munchsubal/5-bit-cla/report.pdf

# VLSI Project

Subal Manchanda : 2024102033

December 2025

## 1 Proposed Structure

I have implemented a 5-bit CLA adder implementation in which we have a Carry-Lookahead Logic broken into 3 parts (2-2-1). I have used AO21 gates for optimising delay along the critical path and also used traditional CMOS gates like AND, NOT. Also, I have used D-Flip Flops for gatekeeping inputs and outputs to ensure proper timing in a real life application. This adder implementation does not use more than 2-input AND Gates which leads to a less fan-in. The block diagram of the circuit is given below:

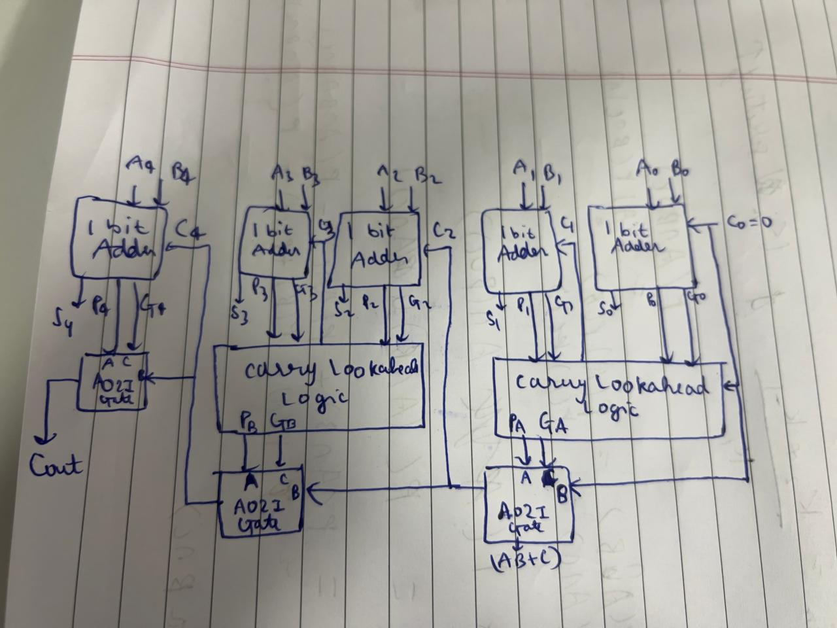
[picture p1: figure]

## 2 Design details of each block

Taking W = 10 * LAMBDA

Gates:

### 2.1 AND GATE

This has been implemented using static CMOS logic with sizing as shown in the figure.

1

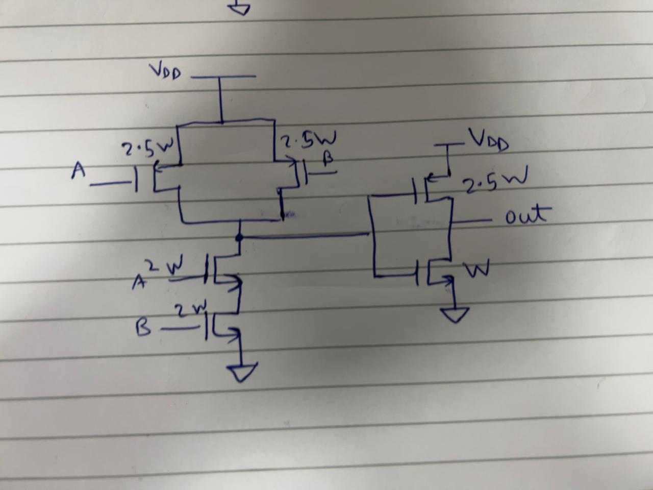
[picture p2: figure]

### 2.2 NOT GATE

This has been implemented using static CMOS logic with sizing as shown in the figure.

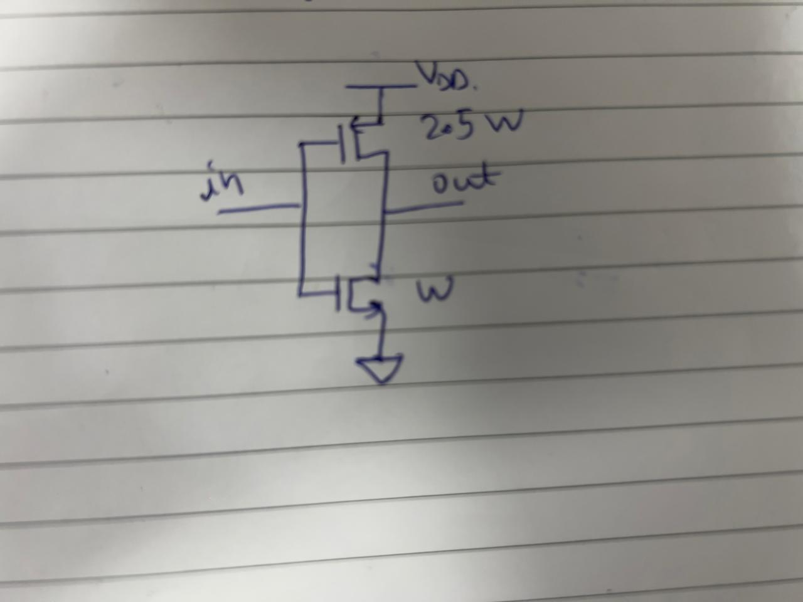
[picture p3: figure]

### 2.3 AO21 Gate

This has been implemented using static CMOS logic with sizing as shown in the figure.

2

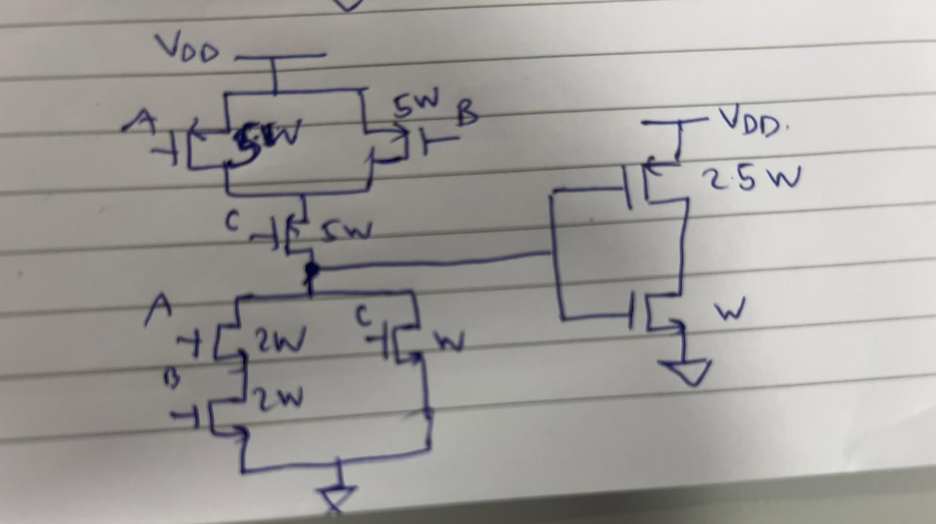
[picture p4: figure]

### 2.4 XOR Gate

This has been implemented using Transmission gate logic with sizing as shown in the figure.

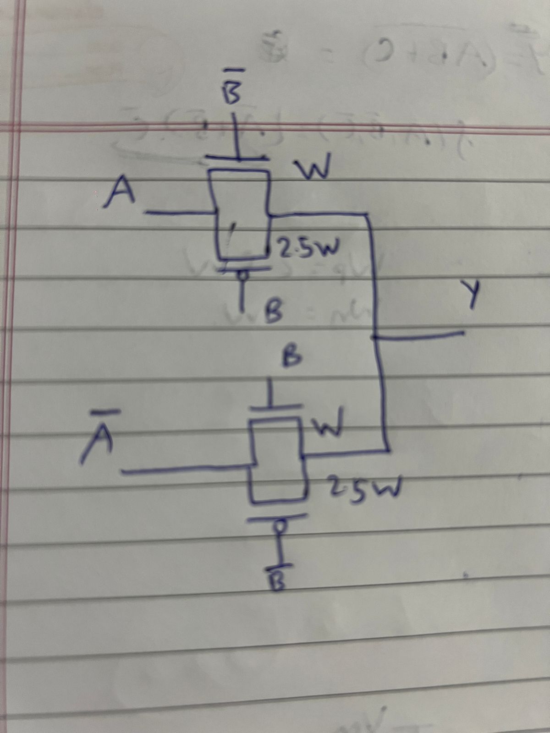
[picture p5: figure]

Different blocks in the circuit:

2.5 1-bit Adder

The adder block has been implemented as follows using the gates we described above:

3

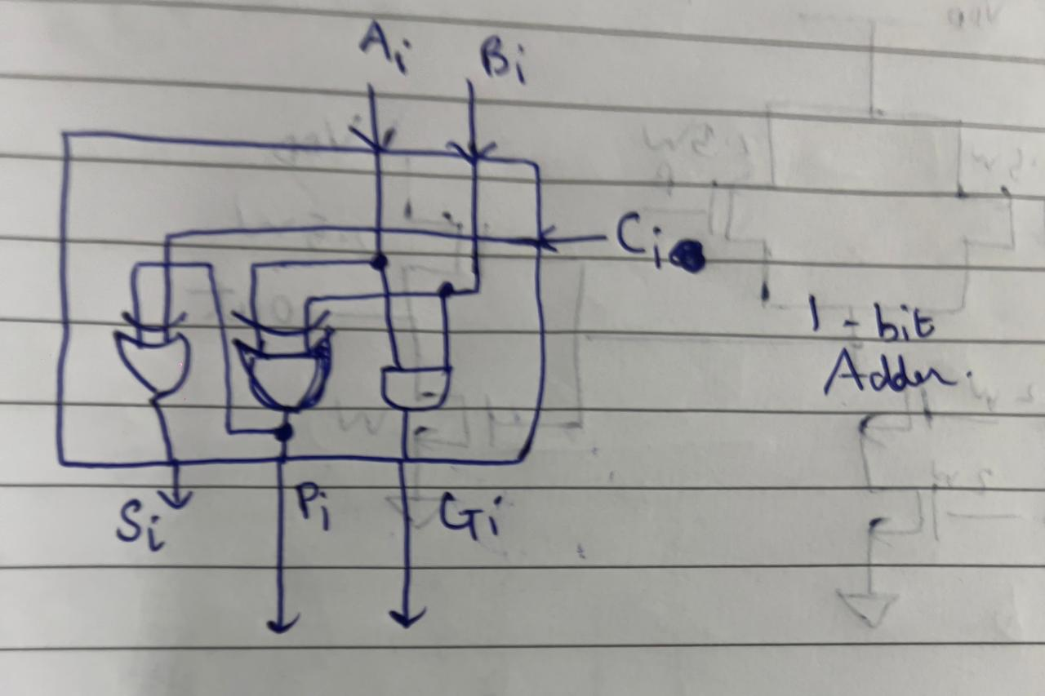
[picture p6: figure]

The adder block provides the propogate and generate bit, along with computing the sum bit as follows:

P = A ⊕ B

G = A · B

S = P ⊕ Cin

### 2.6 Carry Lookahead Logic (CLL) Block

The CLL block has been implemented as follows using the gates we described above:

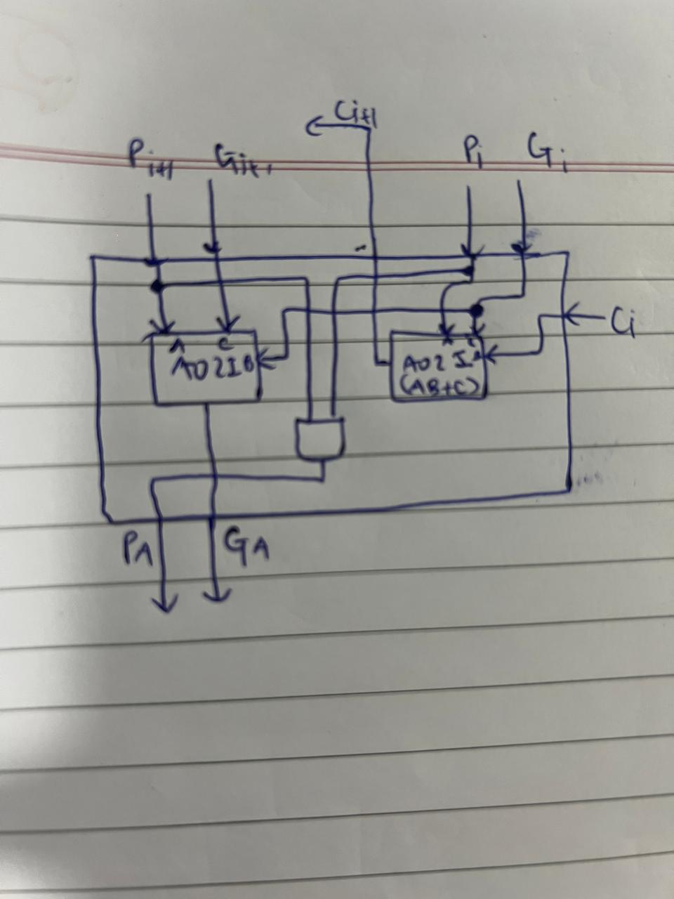
[picture p7: figure]

4

The CLL block implements the following logics:

Ci+1 = Gi + PiCi

PA = Pi+1Pi

GA = Gi+1 + Pi+1Gi

### 2.7 D Flip-Flop

This has been implemented using TSPC logic style as shown in the figure with sizing shown:

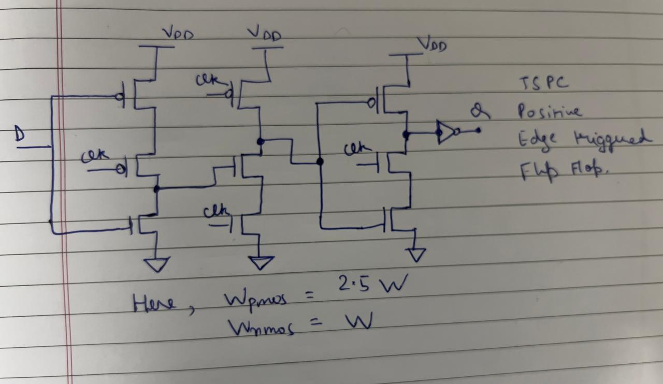
[picture p8: figure]

## 3 Simulating Each Gate seperately:

### 3.1 AND GATE

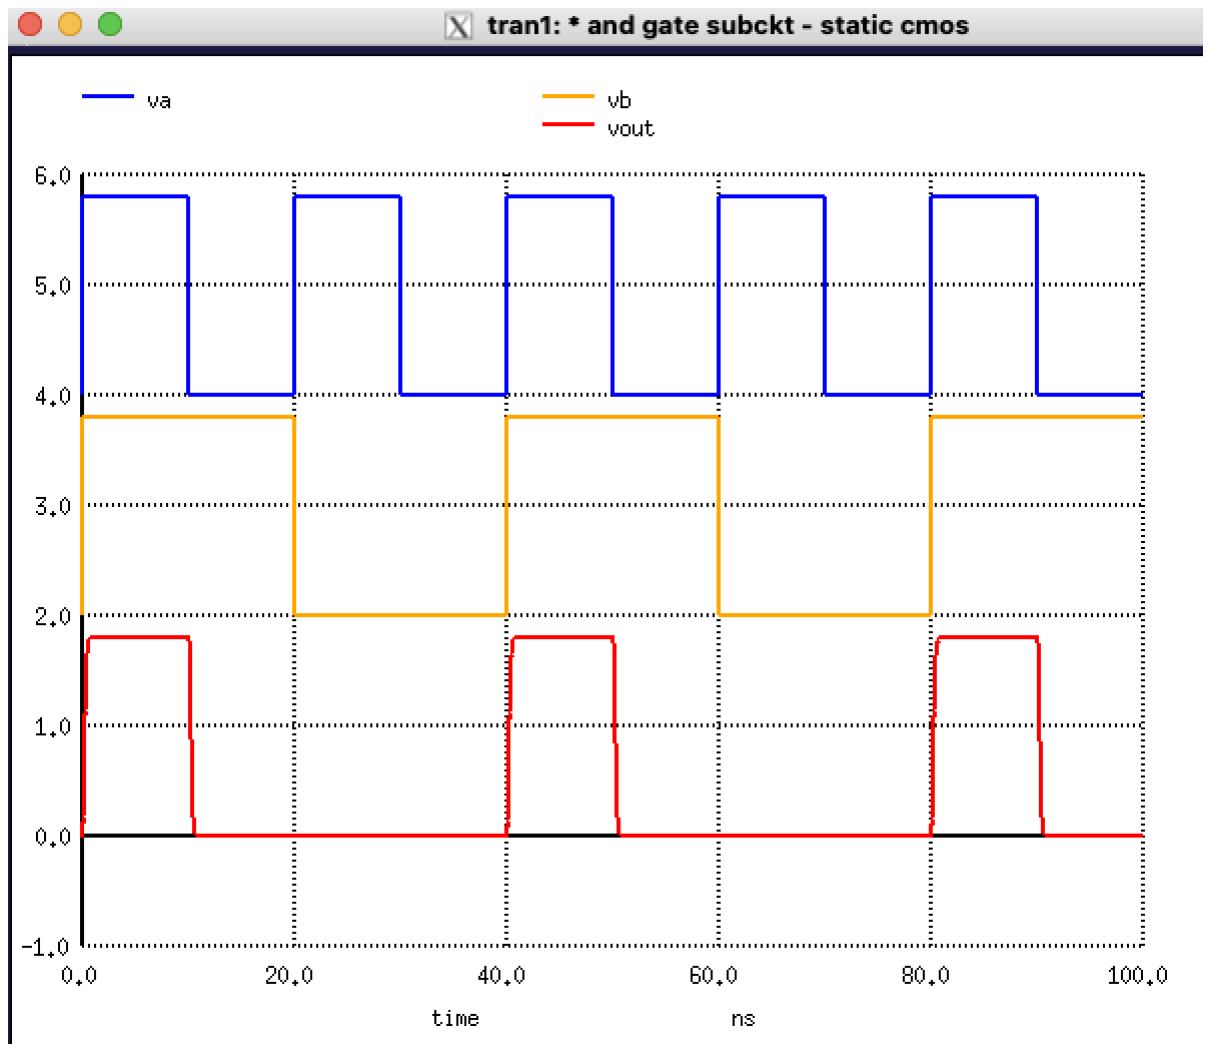
[picture p9: figure]

5

### 3.2 AO21 GATE

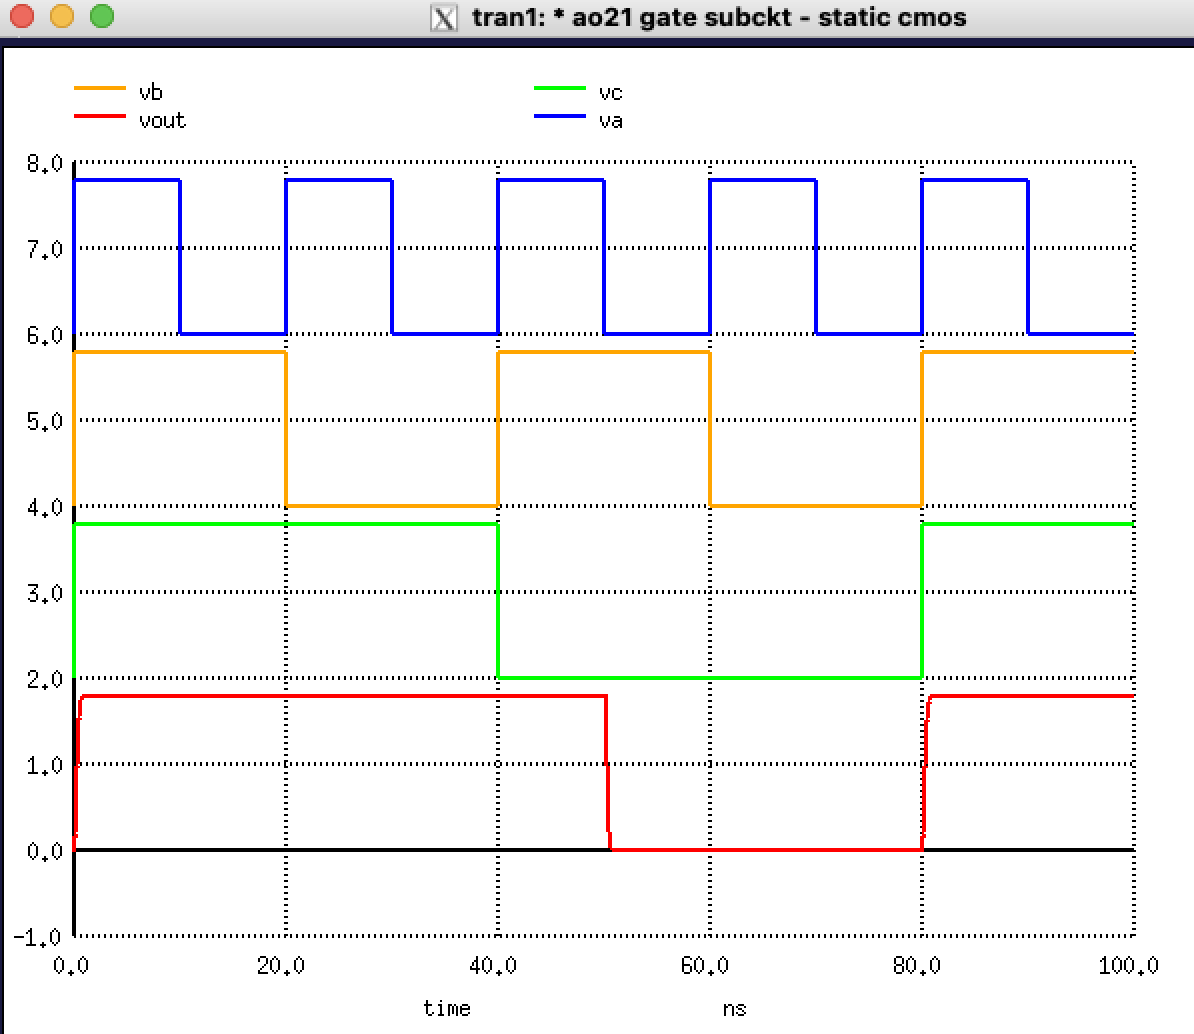
[picture p10: figure]

### 3.3 NOT GATE

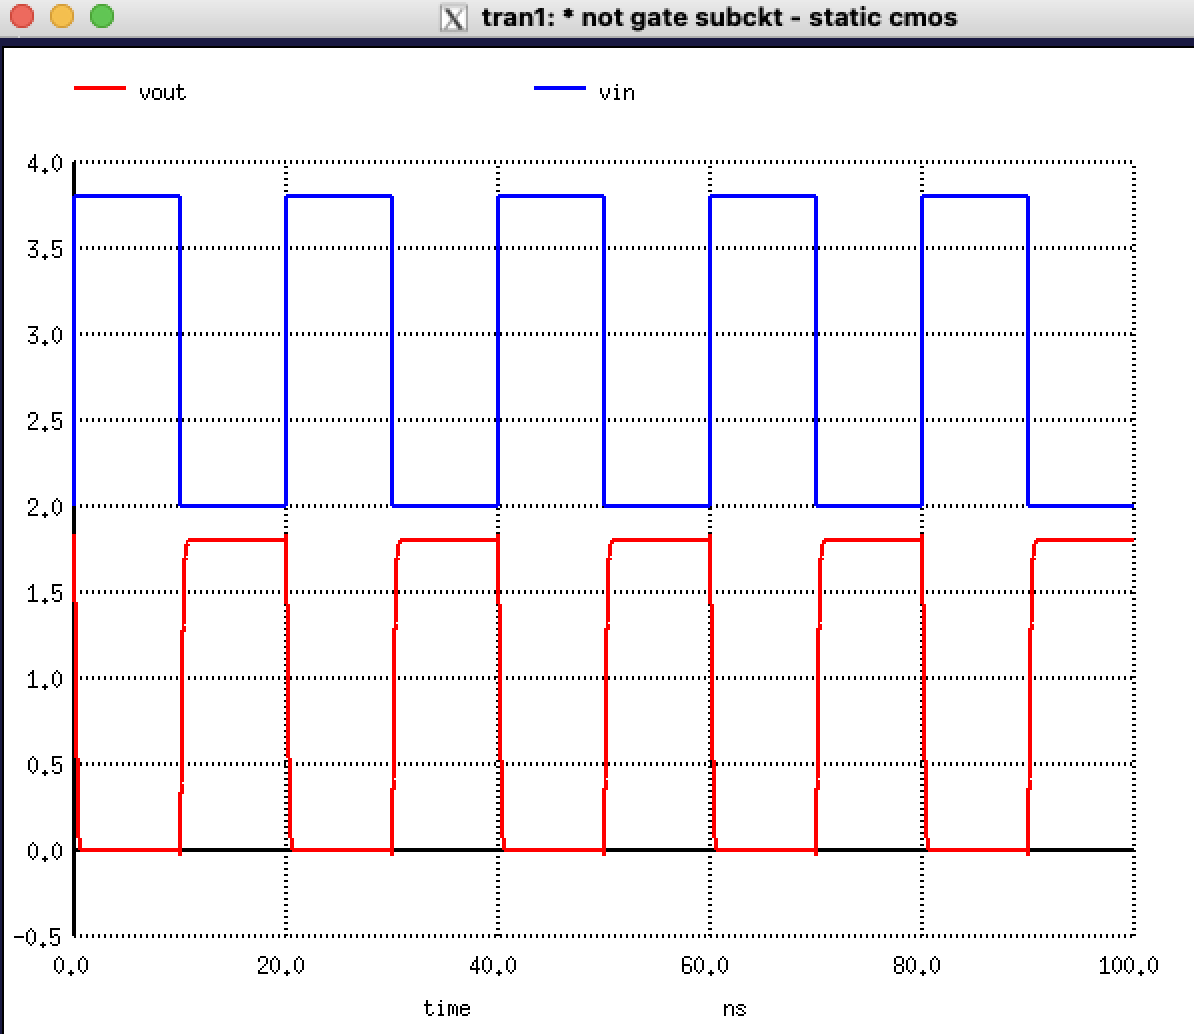
[picture p11: figure]

6

### 3.4 XOR GATE

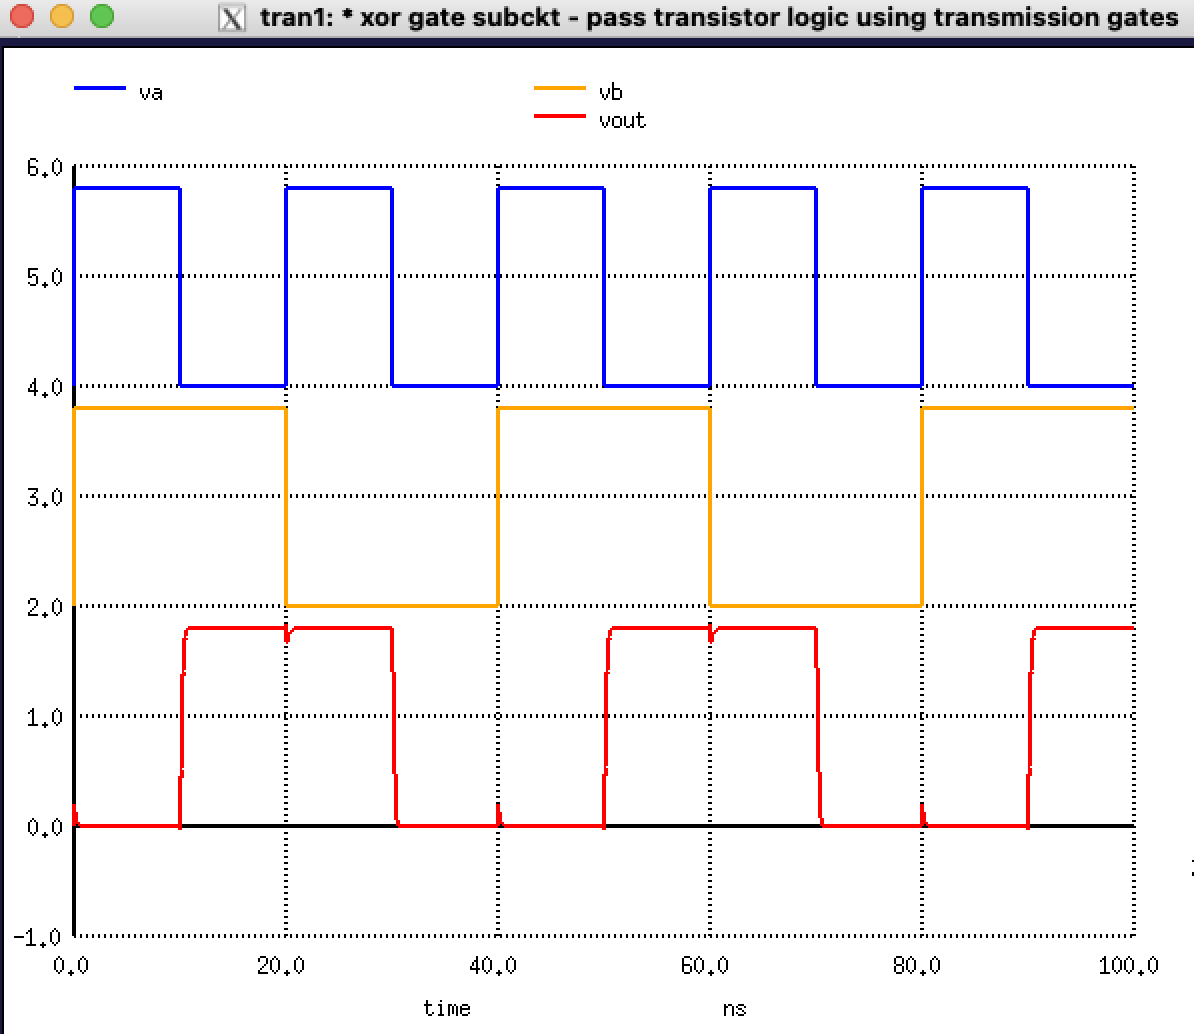
[picture p12: figure]

## 4 Setup Time, Hold Time, Clock to Q Delay for D-Flip Flop

First, we can observe that the D-Flip Flop works as intended.

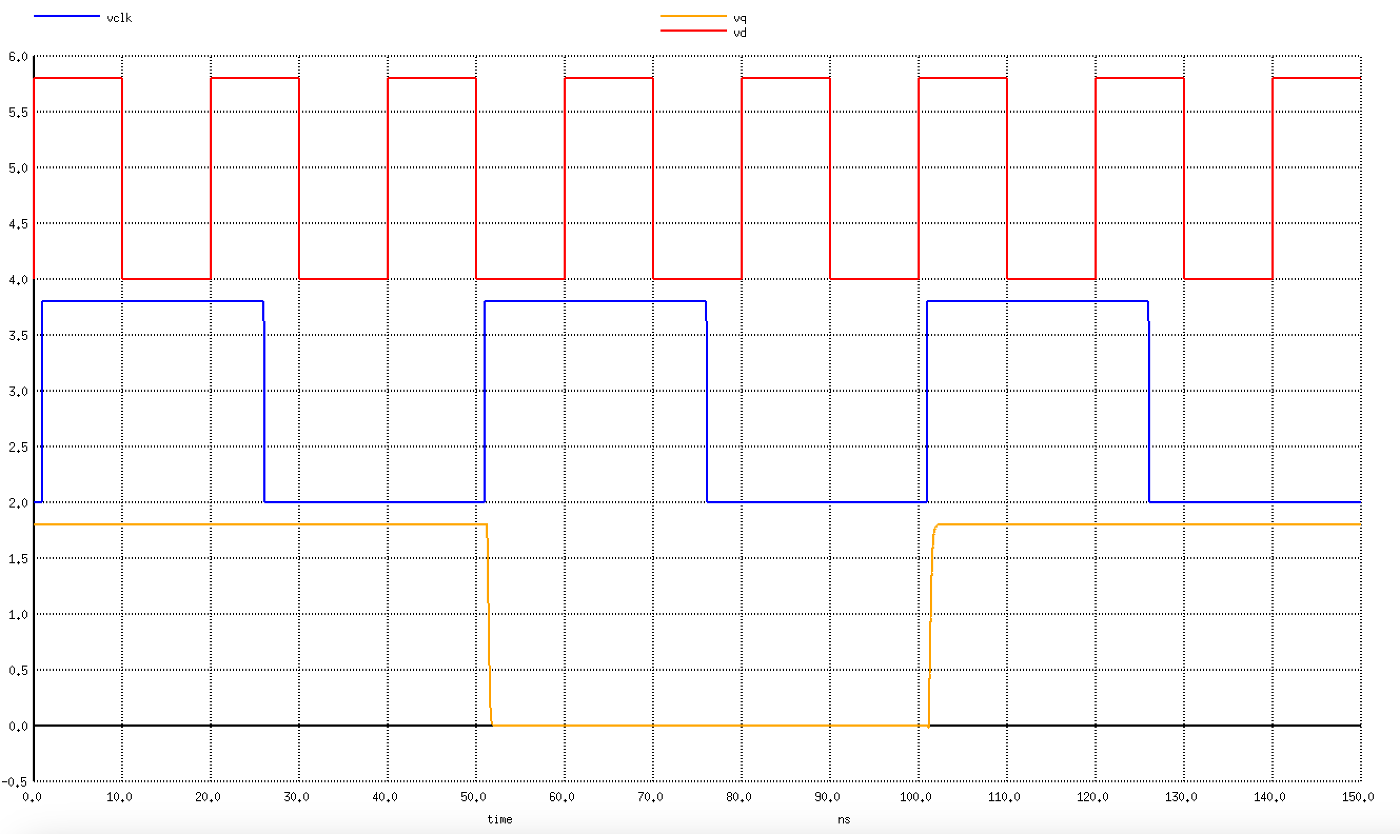
[picture p13: figure]

Then, note that we can argue that the hold time would be approximately 0 since after the positive edge of the clock, the output of gets latched and any change in input would not affect the output.
Then, for the setup time we can find the propogation time of input to the intermediate node X. For Clock to propogation delay, we measured for both cases when the output is rising and when the output is falling. We have obtained these value from simulation as follows:

7

## 5 Stick diagrams for all gates

### 5.1 NOT GATE

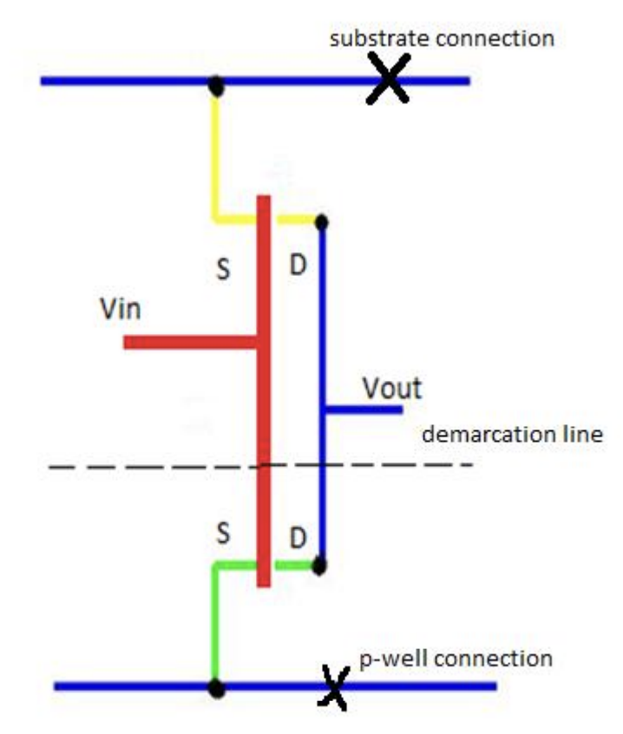
[picture p14: figure]

### 5.2 AND GATE

Since CMOS Implementation of AND Gate is just the CMOS of NAND followed by inverter, we are giving here the stick diagram for NAND which can be cascaded with an inverter (shown above) to obtain the AND function:

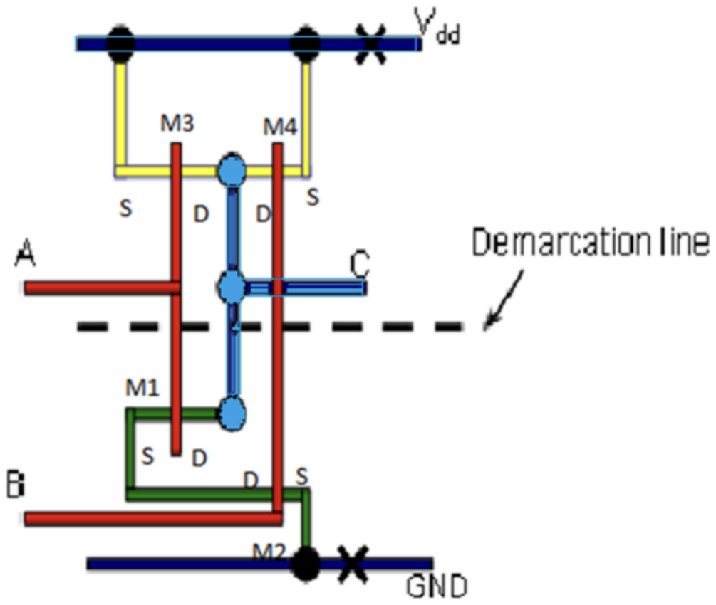
[picture p15: figure]

8

### 5.3 AO21 Gate

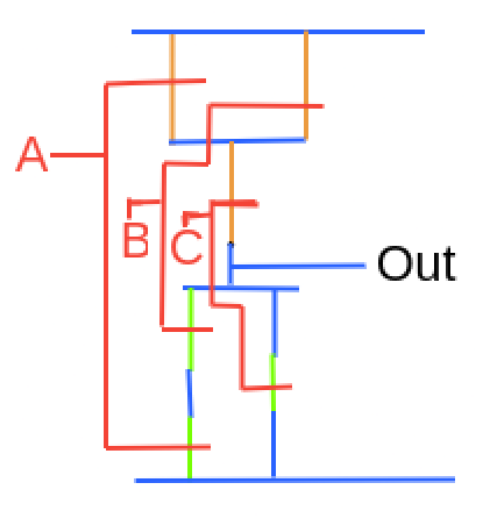
[picture p16: figure]

## 6 Layout for each block

### 6.1 AND GATE

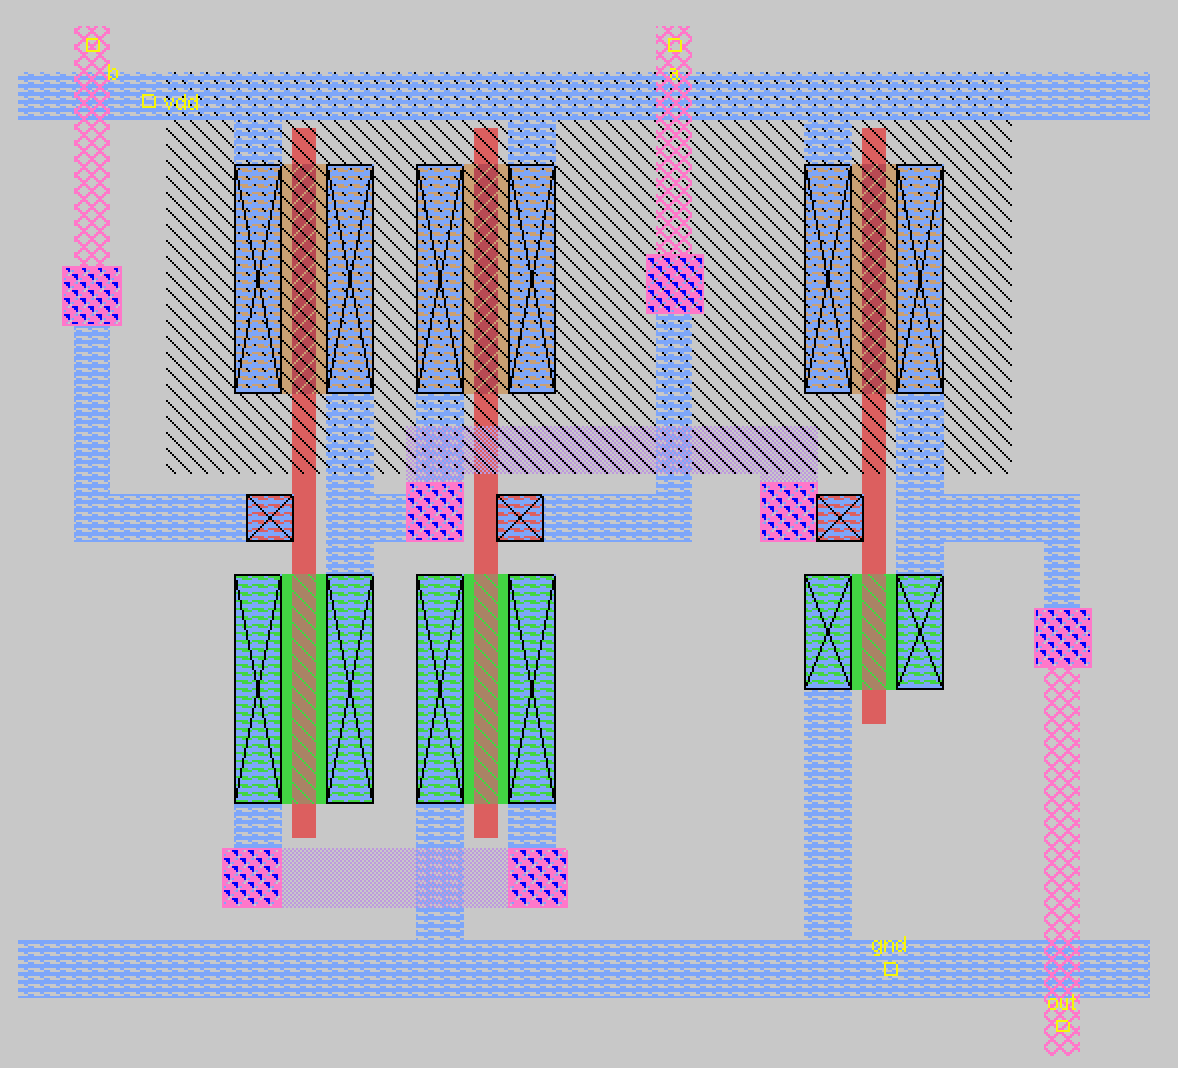
[picture p17: figure]

Post-Layout Simulation:

9

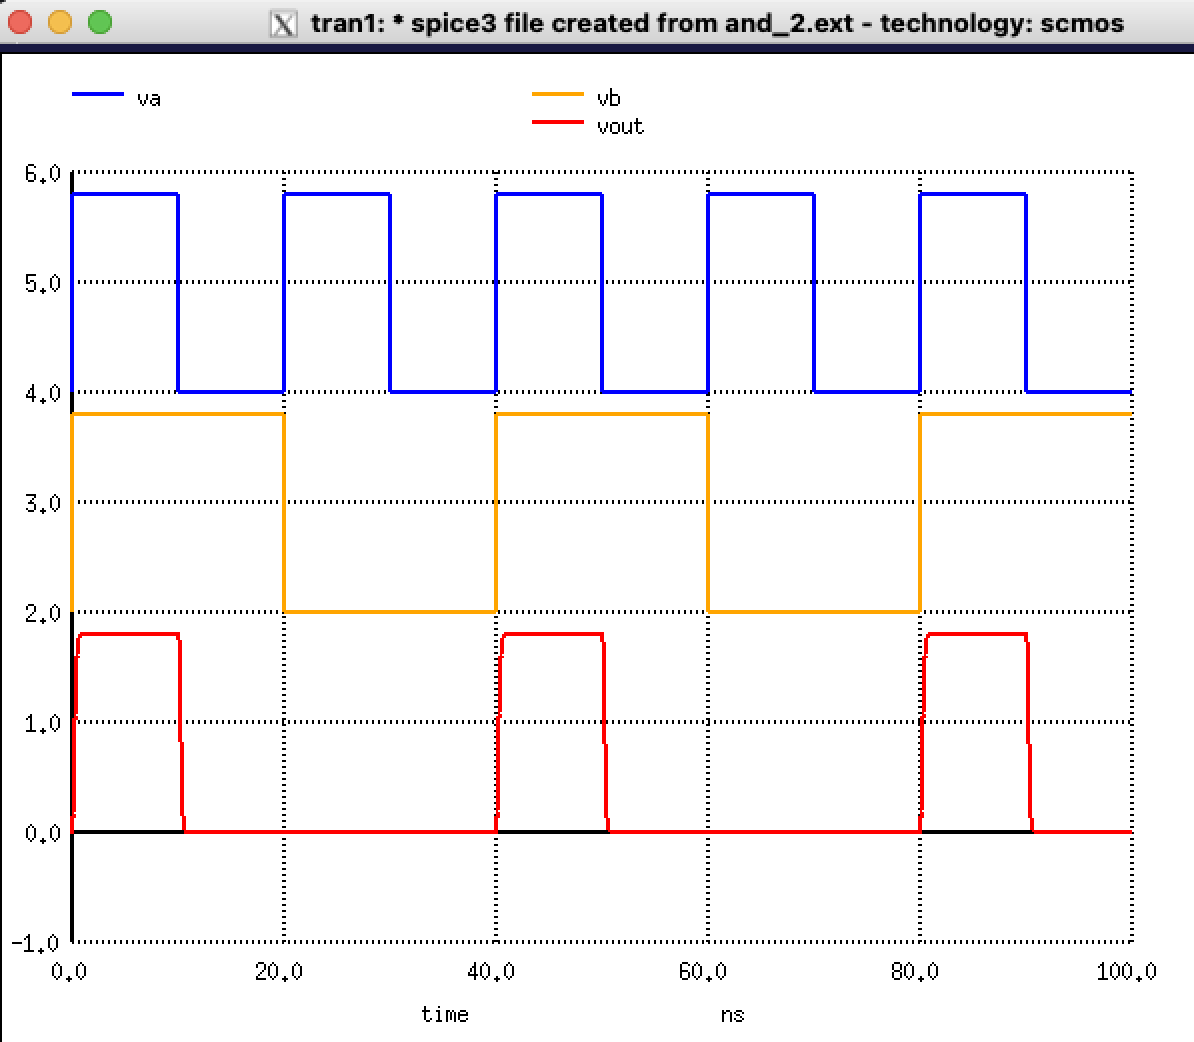
[picture p18: figure]

### 6.2 AO21 GATE

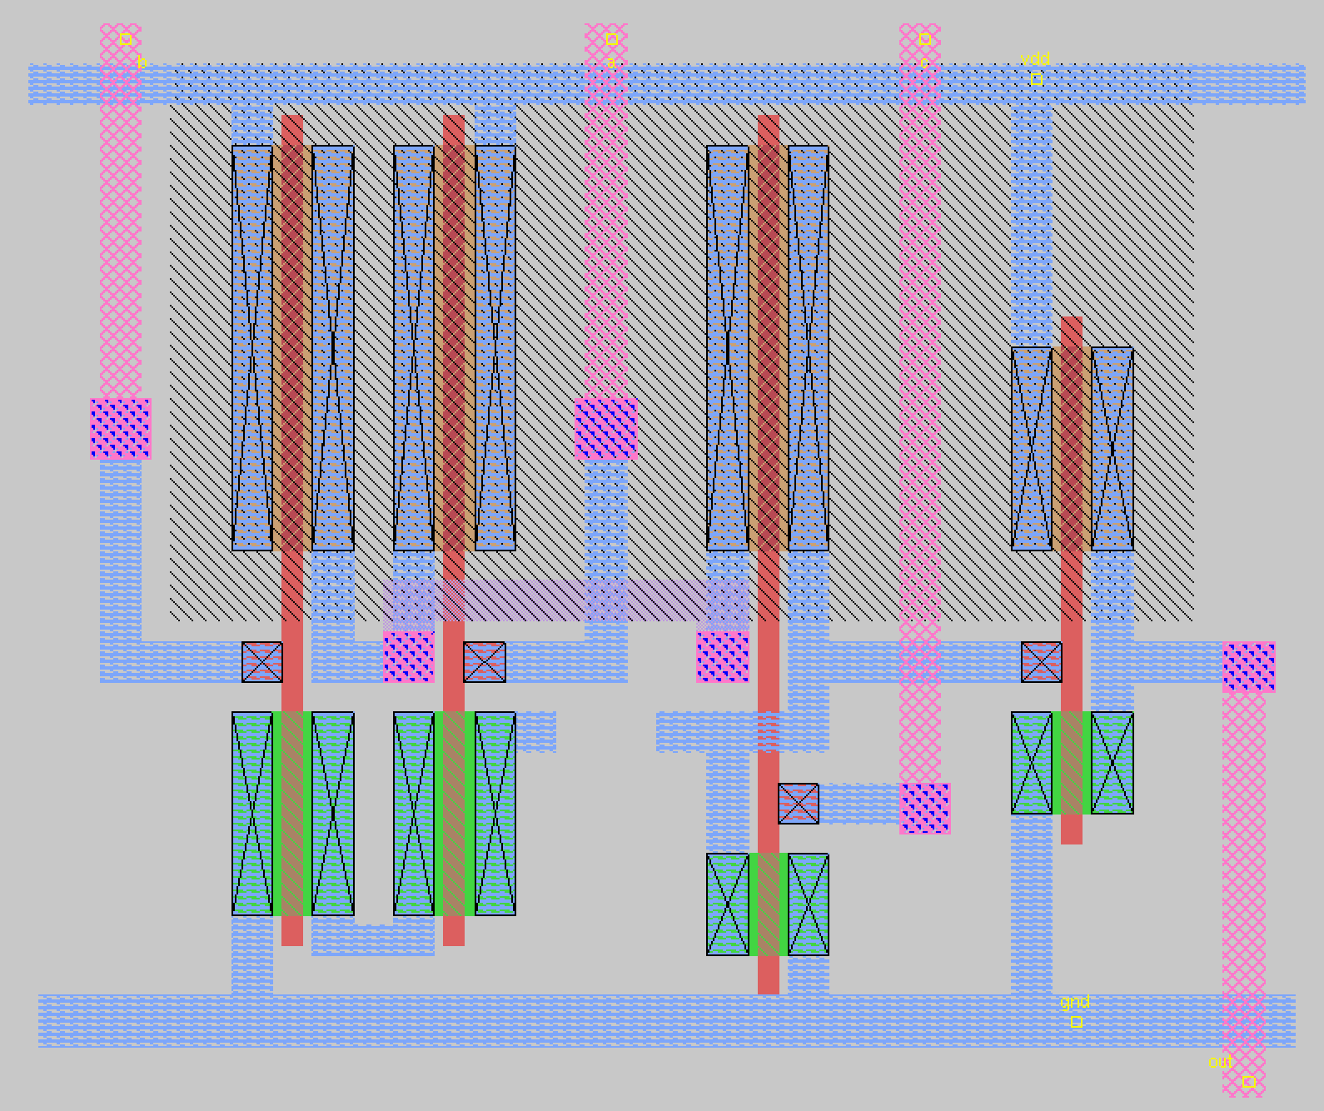
[picture p19: figure]

Post-Layout Simulation:

10

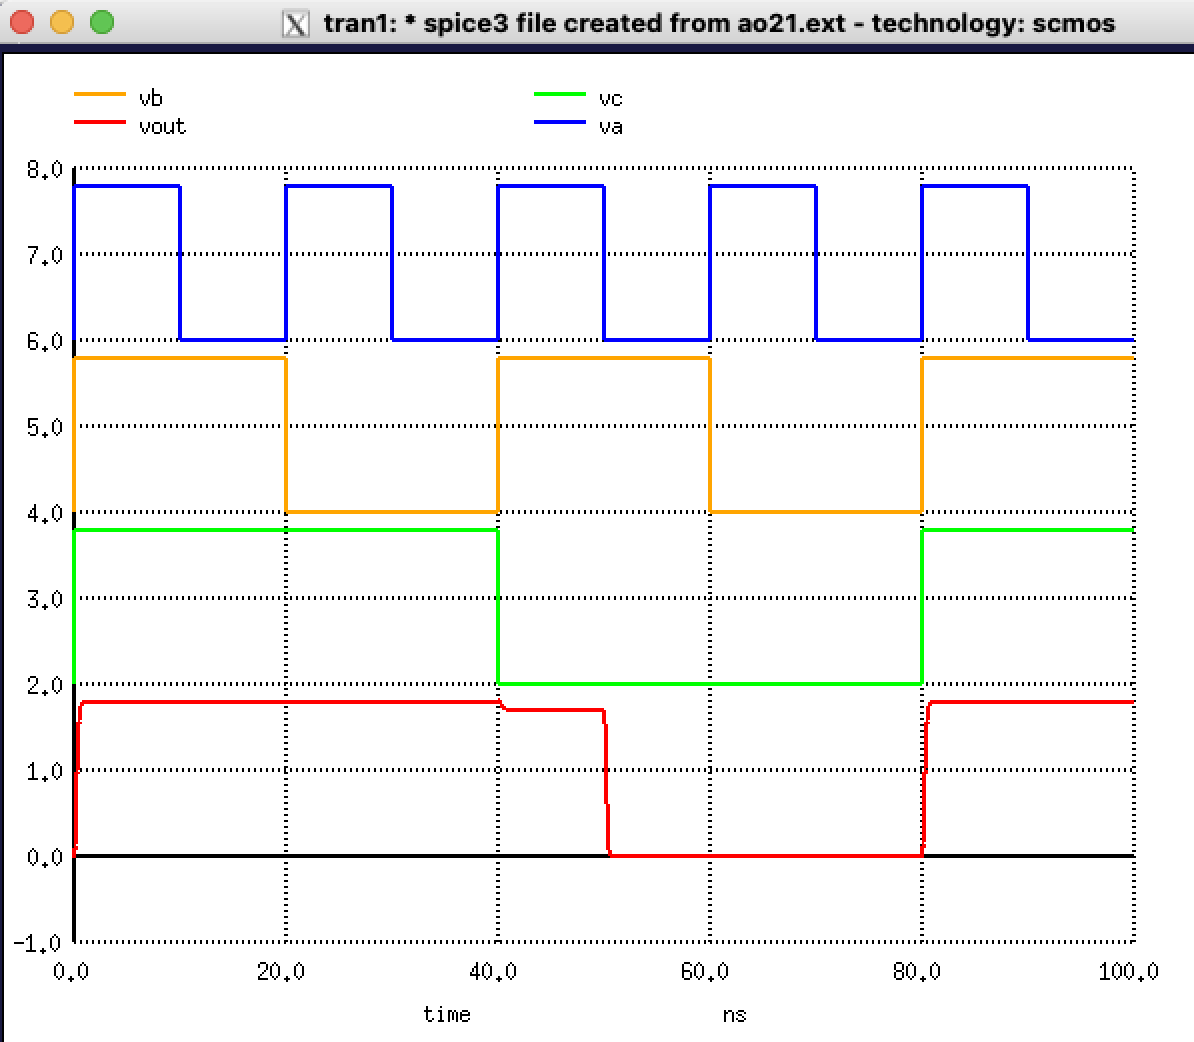
[picture p20: figure]

### 6.3 XOR GATE

Post-Layout Simulation:

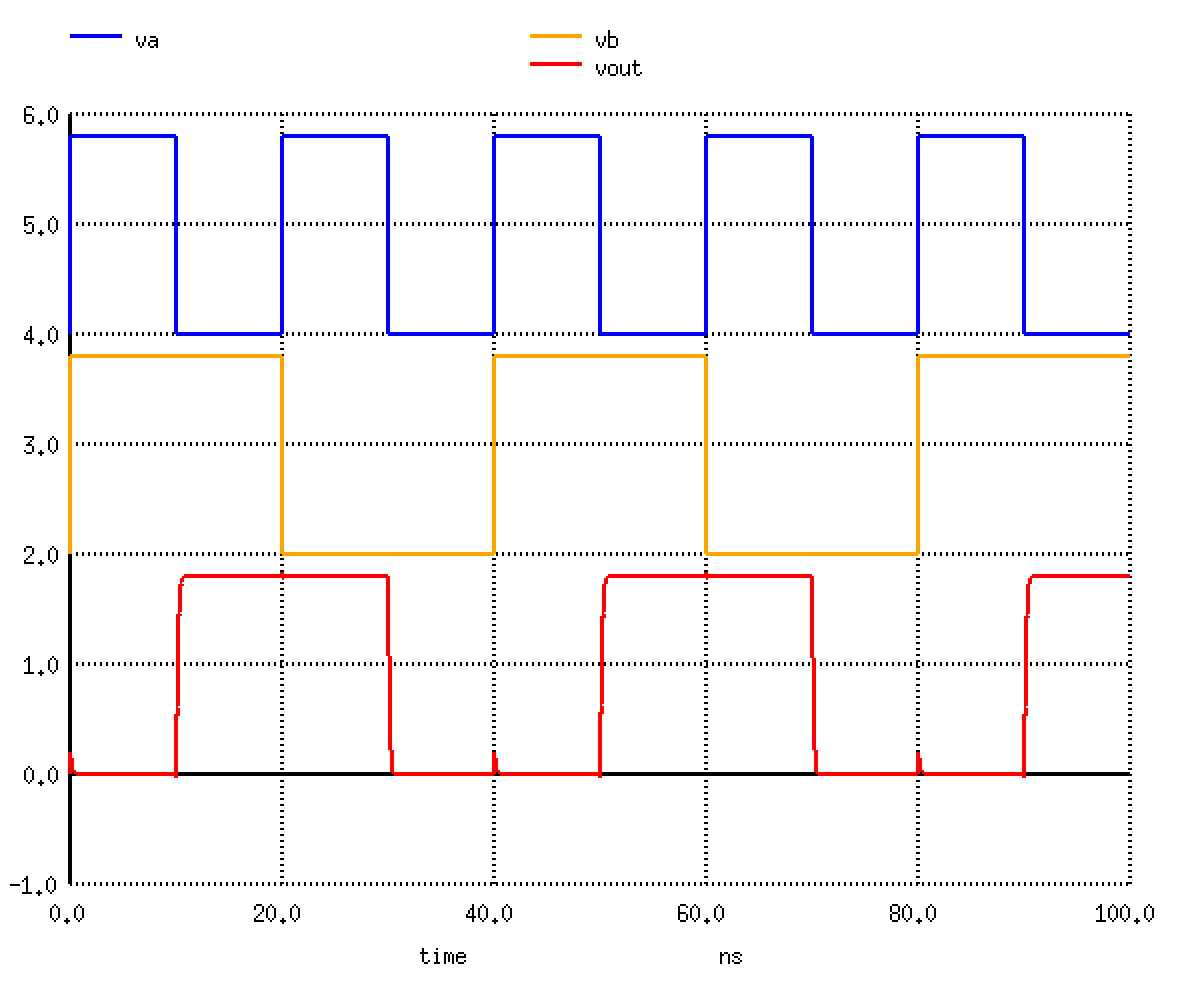
[picture p21: figure]

### 6.4 D Flip Flop

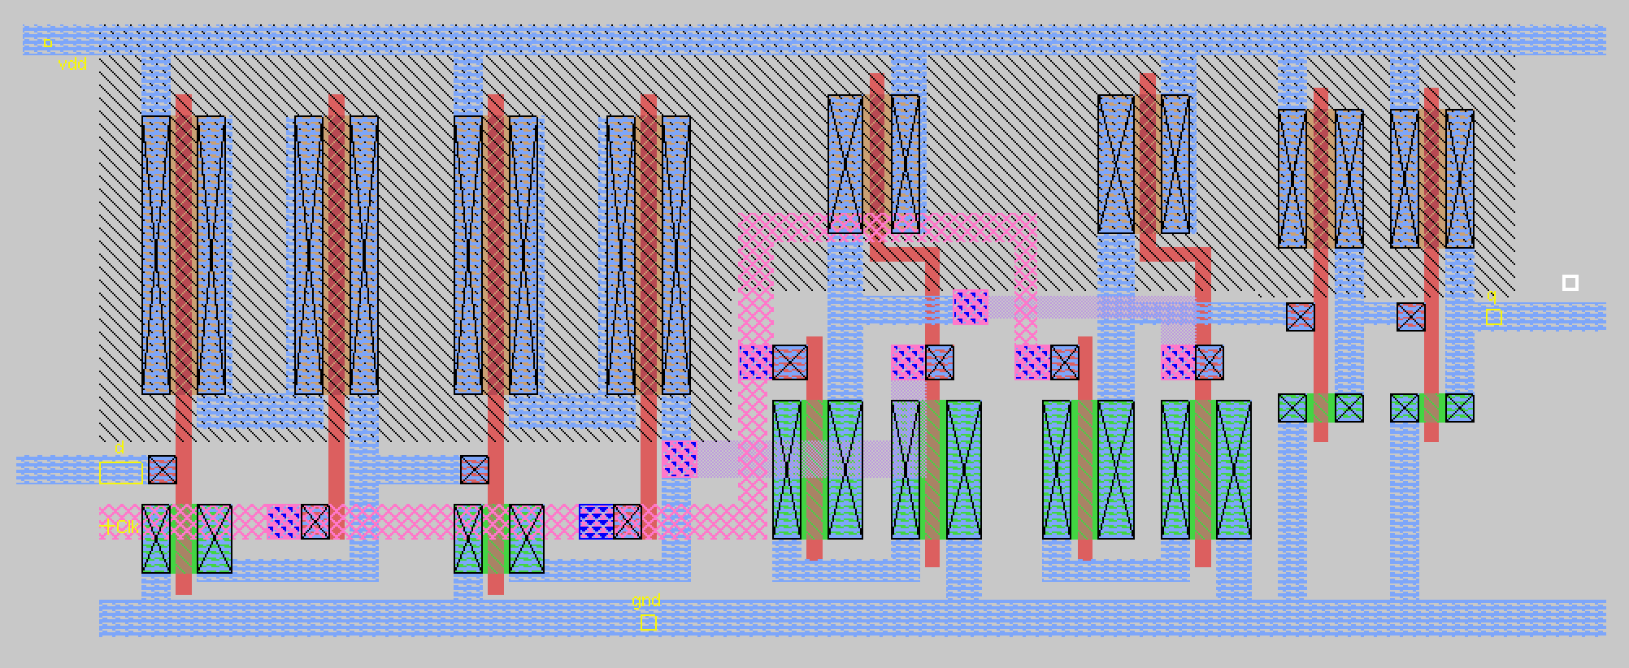
[picture p22: figure]

Post-Layout Simulation:

11

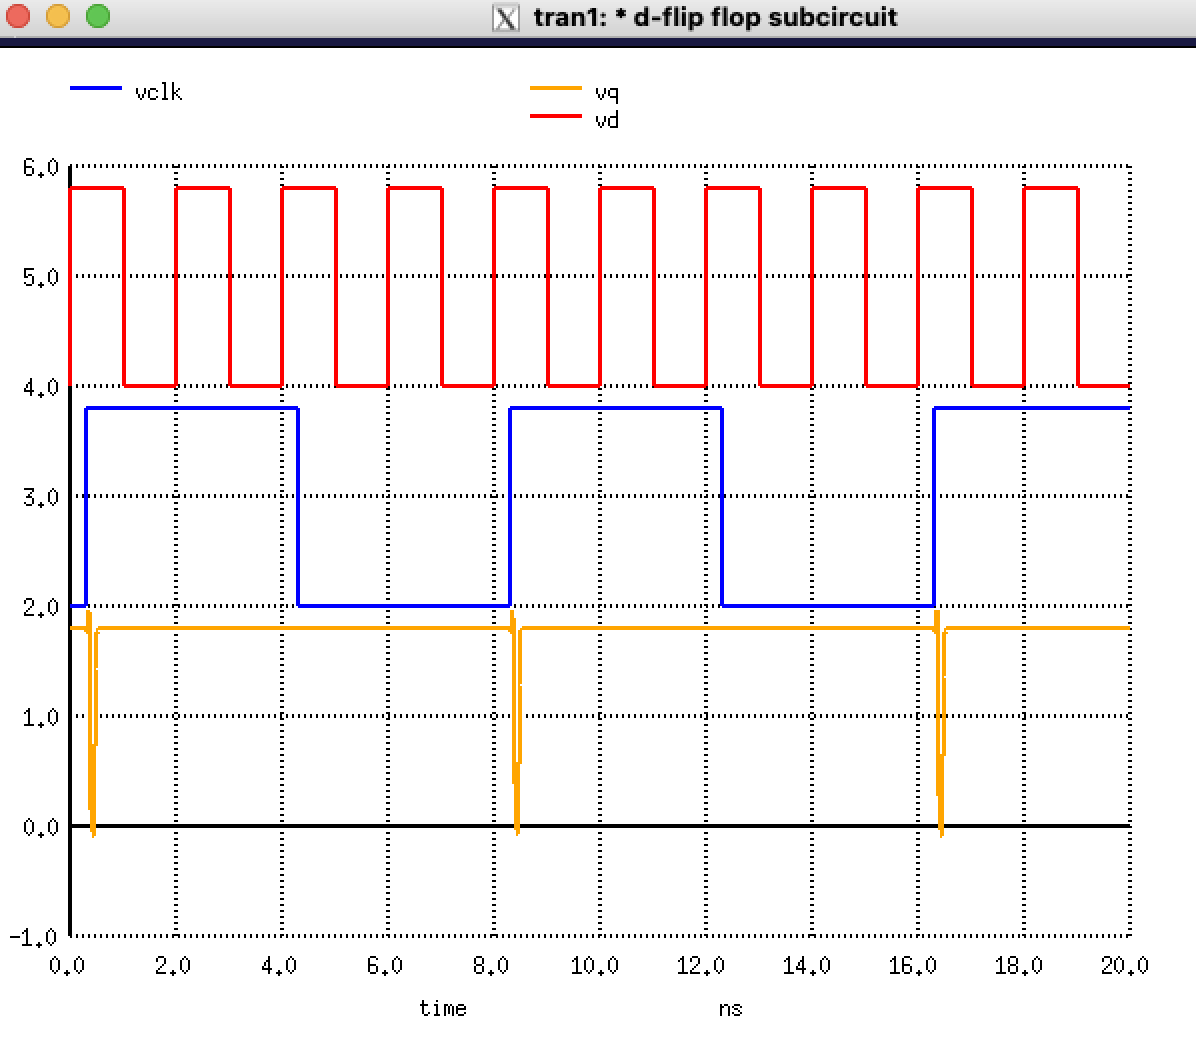
[picture p23: figure]

Using these basic gates, we can implement each part of the circuit as discussed in Section 2.

12

Comparison of Post-Layout and Pre-Layout Results:

From the waveforms, the following observations can be made:

- Propagation delay (tpd): Post-layout vout shows a noticeably larger delay during both rising and falling transitions due to interconnect parasitics (extracted R and C). Thus,

tpd,post > tpd,pre.

- Rise/Fall time degradation: The post-layout output transition is slower and less steep compared to the pre-layout case, indicating increased RC loading:
tr,post > tr,pre, | tf,post > tf,pre.
- Final logic levels: Both pre- and post-layout waveforms reach the correct logic levels, but the post-layout output settles slightly later.
- Overall effect of layout parasitics: The post-layout waveform shows delayed edges, longer transition times, and slightly increased settling time. Functionality is preserved, but timing is degraded.

## 7 Integrating the entire circuit

We will use the 5-bit CLA adder shown in figure 1, along with Flip Flops at inputs and outputs (for gatekeeping) to observe the functioning of the entire circuit.

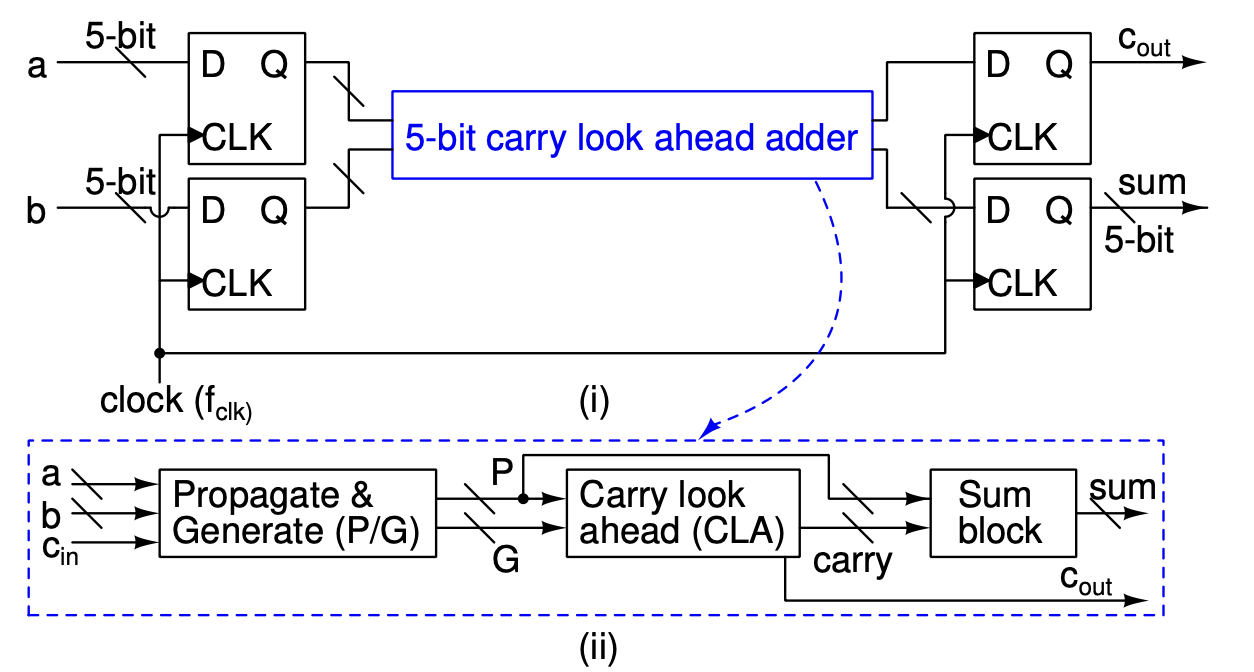
[picture p24: figure]

### 7.1 Finding the Worst Case Delay of the adder circuit

One of the possibilities for the worst case delay of the adder will occur when input numbers are a = 00000 and b = 11111.
This is because in such a case PA = 1 , GA = 0 and PB = 1 , GB = 0 which means S4 will have to wait for C4 which inturn will have to wait for C2 to propogate.
In such a case, we obtain worst case delay. Showing the output of the circuit for this : (Note that the first rising edge does not produce an output, which is

13 because of the fact that the inputs get loaded to the adder in the first rising edge of the clock, thus we start observing output from the second rising edge). As we can clearly see, when a=00000, b=11111 sum = 11111, cout = 0.

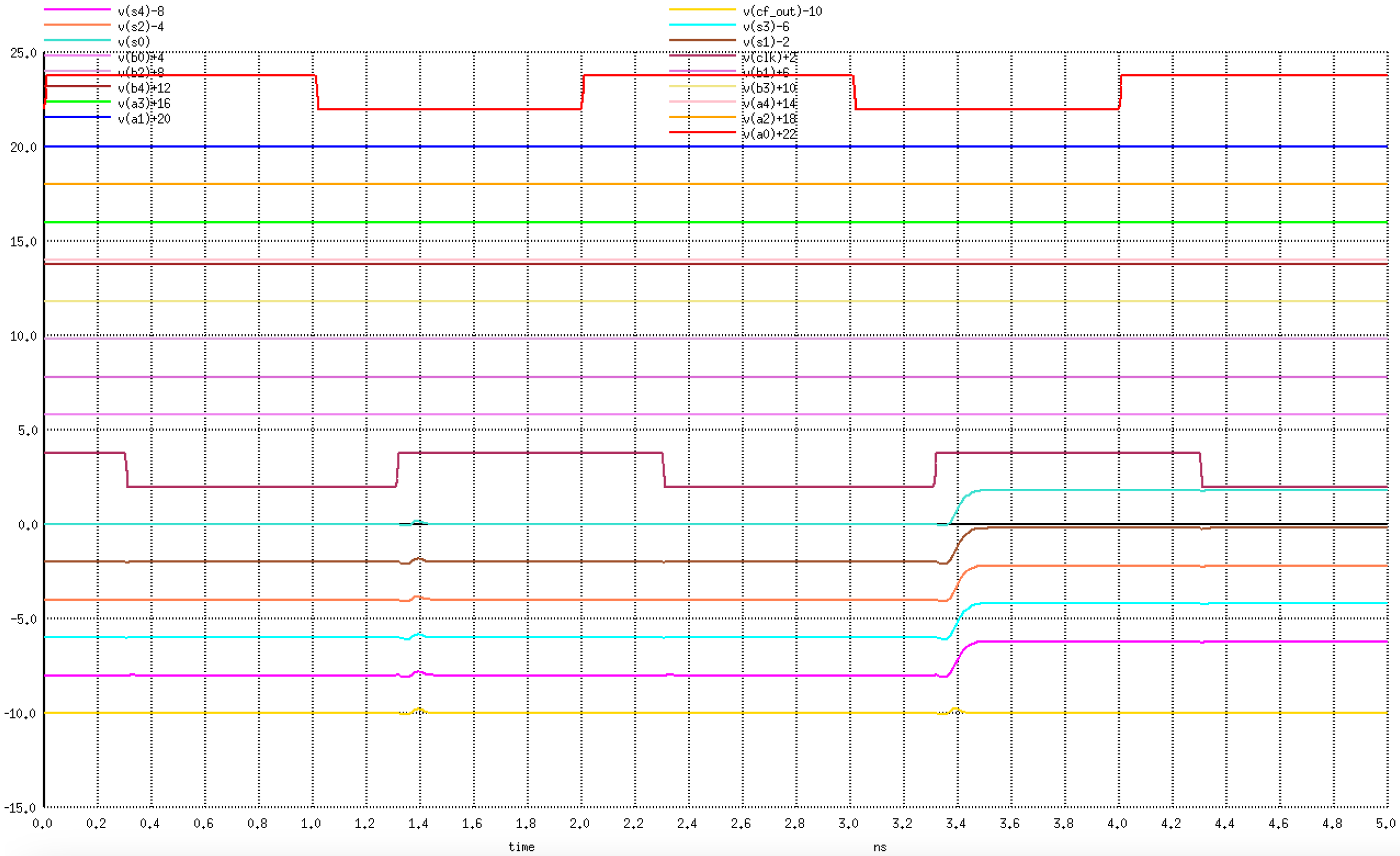
[picture p25: figure]

Note that the delay obtained here from the rising edge of the clk to s4 is the worst case delay of the 5-bit adder.
From simulation results, we obtain:

Delay of 5-bit adder = 84.22ps.

### 7.2 Minimum Clock Period

From timing diagram analysis, we know:

tcq + td ≤ Tclk − tsu

T

min
clk = tcq−max + td + tsu

As obtained in Section 4: Using tsu = 0.053ns, tcq−max = 0.39ns, and td = 0.084ns: We obtain
T

min
clk = 0.534ns

Maximum Clock Frequency = 1.87GHz

14

## 8 Floor Plan and Layout for the Complete Circuit

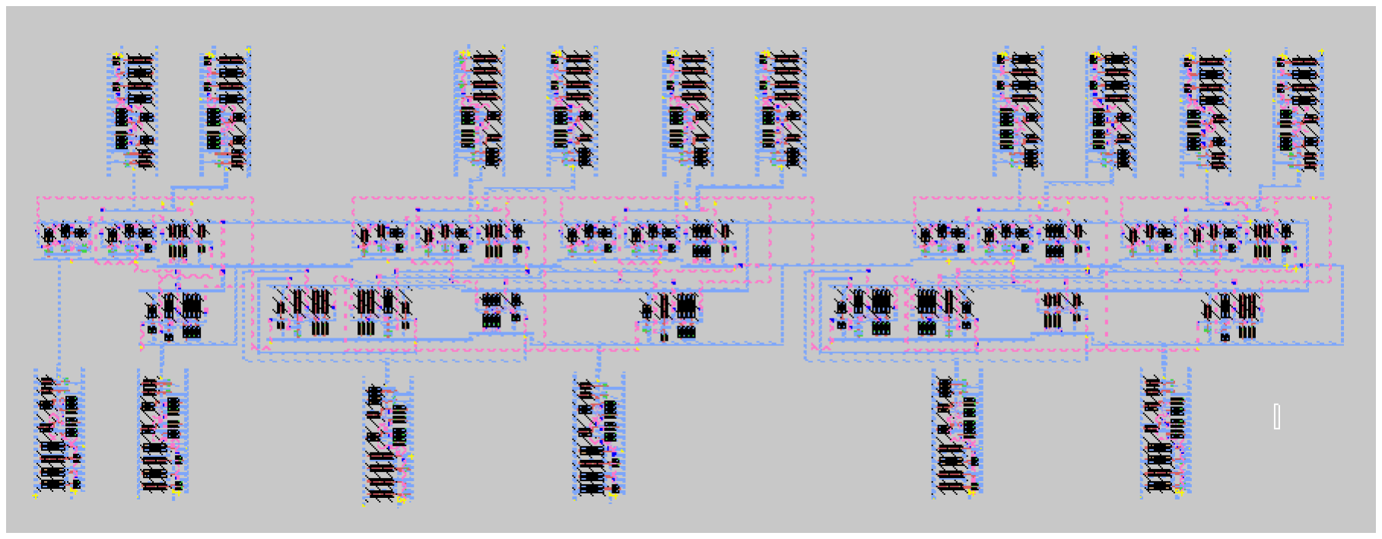
[picture p26: figure]

Horizontal and Vertical Pitch in VLSI Layout
- Pitch is the center-to-center spacing between two repeating layout features.
- Horizontal pitch is the spacing between features along the x-direction.
- Vertical pitch is the spacing between features along the y-direction.

Pitch is used to define the routing grid, standard-cell row spacing, and the regularity of repeated structures in a floorplan or layout.

## 9 Post-Layout Integrated Design

Using the extracted netlist, we have obtained the worst case delay of the adder to be: (Taking input a=00000 b=11111)

## 10 Maximum Clock Frequency

By using static timing analysis, we may obtain:

tcq + td ≤ Tclk − tsu

T

min
clk = tcq−max + td + tsu
Then, we obtain for tsu = 0.053ns, tcq−max = 0.39ns, and td = 95.3p, Maximum Clock Frequency = 1.85GHz

15

## 11 Verilog Description of the 5-bit adder

The verilog code has been attached in the pdf, and one of the outputs obtained in gtkwave is shown:

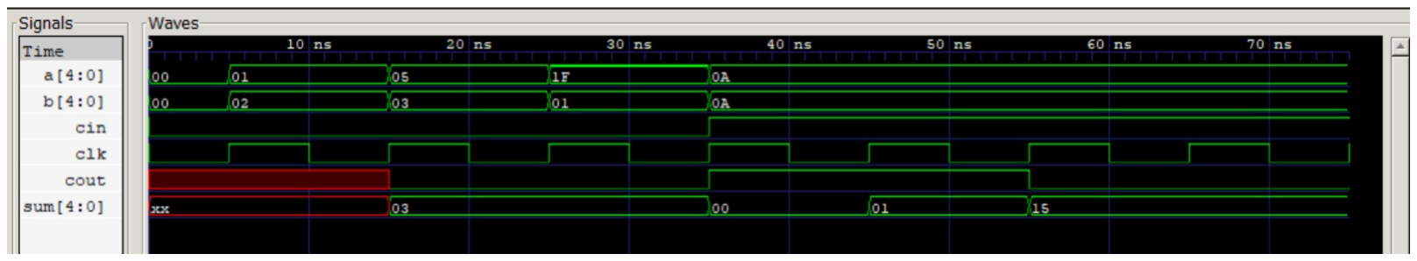
[picture p27: figure]

As observable, it takes one rising edge of the clock for the inputs to reach the adder, and it is the second rising edge at whcich we observe the output to the adder circuit.

## 12 FPGA Simulations

### 12.1 FPGA Verification of 5-bit Adder

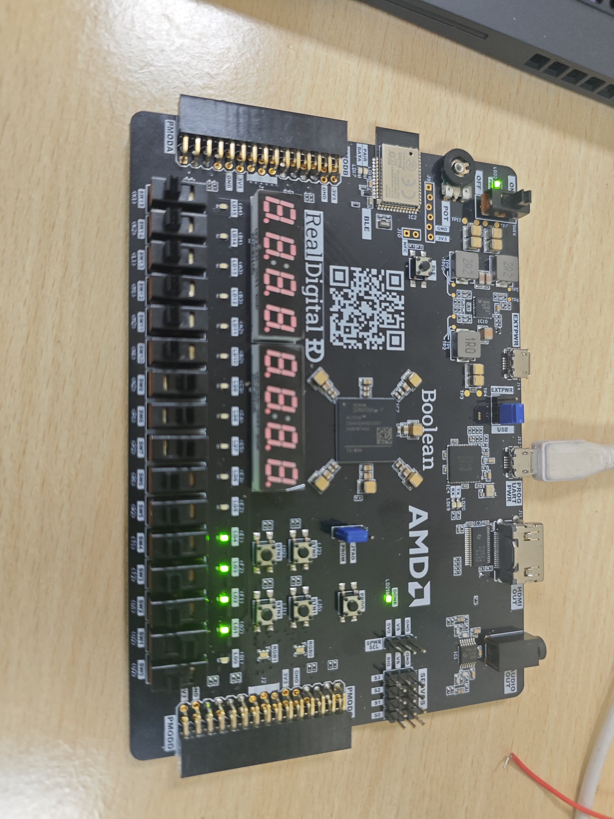
[picture p28: figure]

16

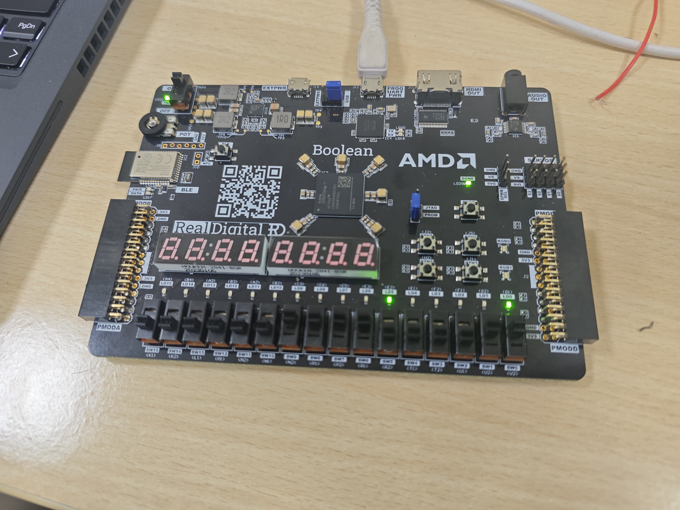
[picture p29: figure]

### 12.2 Oscilloscope Waveform

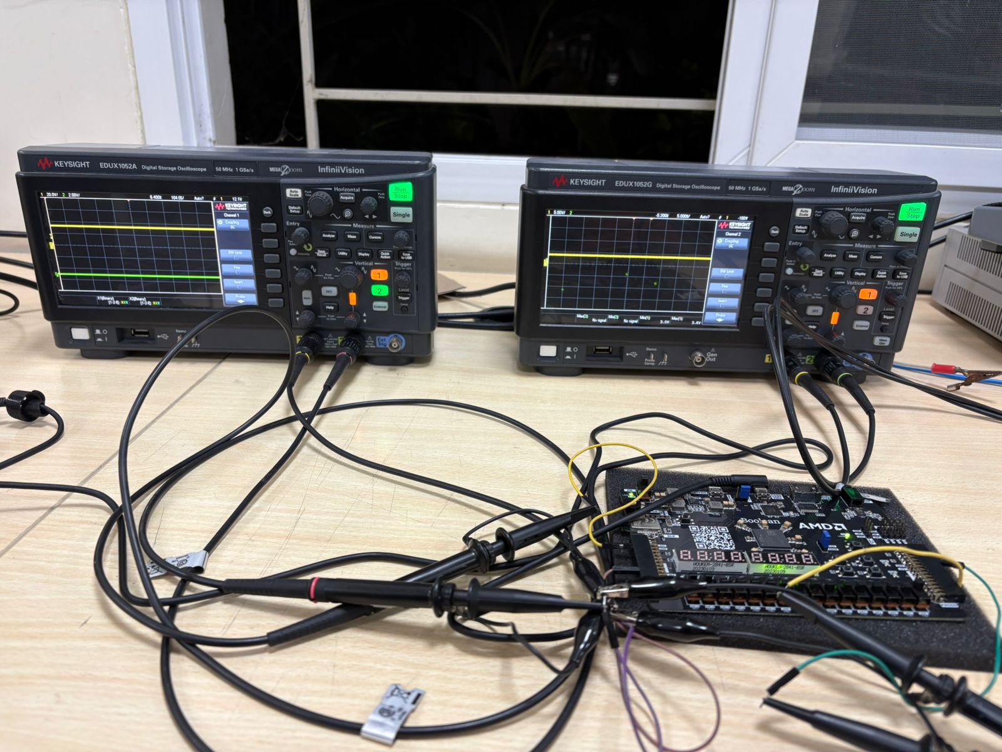
[picture p30: figure]

17
