munchsubal/5-bit-cla/post_layout_stuff/ckt.sp

* 5 bit CLA

.include ../spice/tech/TSMC_180nm.txt

.option scale=90n

* Supply and MOSFET parameters
.param SUPPLY = 1.8

* Voltage Sources
Vdd vdd gnd 1.8
Va0 ain0 gnd 1.8
Va1 ain1 gnd 1.8
Va2 ain2 gnd 1.8
Va3 ain3 gnd 1.8
Va4 ain4 gnd 1.8
Vb0 bin0 gnd 0
Vb1 bin1 gnd 0
Vb2 bin2 gnd 0
Vb3 bin3 gnd 0
Vb4 bin4 gnd pulse(0 1.8 0 0 0 1n 2n)
Vclk clk gnd pulse(1.8 0 0.7n 0 0 2n 4n)
Vc0 c0 gnd 0

M1000 s3 a_2514_527# p3 Gnd CMOSN w=10 l=2
+  ad=50p pd=30u as=50p ps=30u
M1001 a_2173_419# p4 vdd w_2130_412# CMOSP w=40 l=2
+  ad=0.2n pd=90u as=0.2n ps=90u
M1002 vdd a_2938_50# s2out w_2963_31# CMOSP w=20 l=2
+  ad=0.18n pd=58u as=0.18n ps=58u
M1003 p3 a_2443_387# s3 w_2531_553# CMOSP w=20 l=2
+  ad=100p pd=50u as=100p ps=50u
M1004 a_2173_524# a4 gnd Gnd CMOSN w=20 l=2
+  ad=100p pd=50u as=100p ps=50u
M1005 vdd ain2 a_3191_893# w_3183_883# CMOSP w=20 l=2
+  ad=0.18n pd=58u as=0.18n ps=58u
M1006 a_4058_904# clk a_4091_893# w_4083_883# CMOSP w=20 l=2
+  ad=0.18n pd=58u as=0.18n ps=58u
M1007 a_2040_763# a_2029_761# gnd Gnd CMOSN w=10 l=2
+  ad=90p pd=38u as=90p ps=38u
M1008 a_2211_762# a_2200_760# gnd Gnd CMOSN w=10 l=2
+  ad=90p pd=38u as=90p ps=38u
M1009 a_3879_761# clk vdd w_3943_823# CMOSP w=20 l=2
+  ad=0.18n pd=58u as=0.18n ps=58u
M1010 a_2990_763# a_2979_761# gnd Gnd CMOSN w=10 l=2
+  ad=90p pd=38u as=90p ps=38u
M1011 a_2732_524# b3 a_2725_524# Gnd CMOSN w=20 l=2
+  ad=100p pd=50u as=100p ps=50u
M1012 s1 p1 a_3494_527# Gnd CMOSN w=10 l=2
+  ad=50p pd=30u as=50p ps=30u
M1013 vdd bin2 a_3020_894# w_3012_884# CMOSP w=20 l=2
+  ad=0.18n pd=58u as=0.18n ps=58u
M1014 vdd a_2200_760# a_2237_700# w_2263_741# CMOSP w=20 l=2
+  ad=0.18n pd=58u as=0.18n ps=58u
M1015 gnd clk a_2545_833# Gnd CMOSN w=10 l=2
+  ad=90p pd=38u as=90p ps=38u
M1016 a_3378_426# gA a_3346_397# w_3335_419# CMOSP w=40 l=2
+  ad=0.2n pd=90u as=0.2n ps=90u
M1017 a_2559_254# a_2136_393# gnd Gnd CMOSN w=10 l=2
+  ad=90p pd=38u as=90p ps=38u
M1018 gnd clk a_2716_832# Gnd CMOSN w=10 l=2
+  ad=90p pd=38u as=90p ps=38u
M1019 a_2626_527# a3 vdd w_2613_546# CMOSP w=20 l=2
+  ad=100p pd=50u as=100p ps=50u
M1020 p1 a_3606_527# b1 Gnd CMOSN w=10 l=2
+  ad=50p pd=30u as=50p ps=30u
M1021 vdd ain0 a_4091_893# w_4083_883# CMOSP w=20 l=2
+  ad=0.18n pd=58u as=0.18n ps=58u
M1022 a_2211_762# clk a_2237_700# Gnd CMOSN w=10 l=2
+  ad=90p pd=38u as=90p ps=38u
M1023 vdd a_2979_761# a_3016_701# w_3042_742# CMOSP w=20 l=2
+  ad=0.18n pd=58u as=0.18n ps=58u
M1024 b1 a1 p1 w_3623_553# CMOSP w=20 l=2
+  ad=100p pd=50u as=100p ps=50u
M1025 a_2705_760# clk vdd w_2769_822# CMOSP w=20 l=2
+  ad=0.18n pd=58u as=0.18n ps=58u
M1026 vdd a_3150_760# a_3187_700# w_3213_741# CMOSP w=20 l=2
+  ad=0.18n pd=58u as=0.18n ps=58u
M1027 gnd a_2066_701# b4 Gnd CMOSN w=10 l=2
+  ad=90p pd=38u as=90p ps=38u
M1028 gB a_2549_386# vdd w_2496_419# CMOSP w=20 l=2
+  ad=100p pd=50u as=100p ps=50u
M1029 gnd a_2288_50# s3out Gnd CMOSN w=10 l=2
+  ad=90p pd=38u as=90p ps=38u
M1030 a_3879_761# a_3887_905# a_3890_833# Gnd CMOSN w=10 l=2
+  ad=90p pd=38u as=90p ps=38u
M1031 a_3890_763# a_3879_761# gnd Gnd CMOSN w=10 l=2
+  ad=90p pd=38u as=90p ps=38u
M1032 gnd a_2237_700# a4 Gnd CMOSN w=10 l=2
+  ad=90p pd=38u as=90p ps=38u
M1033 p2 b2 a2 w_3006_553# CMOSP w=20 l=2
+  ad=100p pd=50u as=100p ps=50u
M1034 vdd a_2141_390# a_2136_393# w_2130_412# CMOSP w=20 l=2
+  ad=100p pd=50u as=100p ps=50u
M1035 a_2204_383# p4 a_2197_383# Gnd CMOSN w=20 l=2
+  ad=100p pd=50u as=100p ps=50u
M1036 gnd a_2366_397# C4 Gnd CMOSN w=10 l=2
+  ad=50p pd=30u as=50p ps=30u
M1037 a_1959_254# s4 gnd Gnd CMOSN w=10 l=2
+  ad=90p pd=38u as=90p ps=38u
M1038 a_2534_761# a_2542_905# a_2545_833# Gnd CMOSN w=10 l=2
+  ad=90p pd=38u as=90p ps=38u
M1039 gnd clk a_3445_833# Gnd CMOSN w=10 l=2
+  ad=90p pd=38u as=90p ps=38u
M1040 a_2040_763# clk a_2066_701# Gnd CMOSN w=10 l=2
+  ad=90p pd=38u as=90p ps=38u
M1041 a_2705_760# a_2713_904# a_2716_832# Gnd CMOSN w=10 l=2
+  ad=90p pd=38u as=90p ps=38u
M1042 gnd clk a_3616_832# Gnd CMOSN w=10 l=2
+  ad=90p pd=38u as=90p ps=38u
M1043 a_3705_524# a1 gnd Gnd CMOSN w=20 l=2
+  ad=100p pd=50u as=100p ps=50u
M1044 gnd a_3016_701# b2 Gnd CMOSN w=10 l=2
+  ad=90p pd=38u as=90p ps=38u
M1045 vdd C2 a_3038_420# w_2995_413# CMOSP w=40 l=2
+  ad=0.2n pd=90u as=0.2n ps=90u
M1046 a_3529_386# g1 a_3489_426# w_3476_419# CMOSP w=40 l=2
+  ad=0.2n pd=90u as=0.2n ps=90u
M1047 s2 p2 a_2877_527# Gnd CMOSN w=10 l=2
+  ad=50p pd=30u as=50p ps=30u
M1048 a_2990_763# clk a_3016_701# Gnd CMOSN w=10 l=2
+  ad=90p pd=38u as=90p ps=38u
M1049 vdd a_4050_760# a_4087_700# w_4113_741# CMOSP w=20 l=2
+  ad=0.18n pd=58u as=0.18n ps=58u
M1050 s0 p0 a_3857_527# Gnd CMOSN w=10 l=2
+  ad=50p pd=30u as=50p ps=30u
M1051 a_2909_254# s2 gnd Gnd CMOSN w=10 l=2
+  ad=90p pd=38u as=90p ps=38u
M1052 a_3605_760# clk vdd w_3669_822# CMOSP w=20 l=2
+  ad=0.18n pd=58u as=0.18n ps=58u
M1053 gnd clk a_3862_182# Gnd CMOSN w=10 l=2
+  ad=90p pd=38u as=90p ps=38u
M1054 pA a_3709_404# gnd Gnd CMOSN w=10 l=2
+  ad=50p pd=30u as=50p ps=30u
M1055 a_3069_384# p2 a_3062_384# Gnd CMOSN w=20 l=2
+  ad=100p pd=50u as=100p ps=50u
M1056 a_4075_524# b0 a_4068_524# Gnd CMOSN w=20 l=2
+  ad=100p pd=50u as=100p ps=50u
M1057 a_3434_761# a_3442_905# a_3445_833# Gnd CMOSN w=10 l=2
+  ad=90p pd=38u as=90p ps=38u
M1058 a_2037_905# clk a_2070_894# w_2062_884# CMOSP w=20 l=2
+  ad=0.18n pd=58u as=0.18n ps=58u
M1059 a_3605_760# a_3613_904# a_3616_832# Gnd CMOSN w=10 l=2
+  ad=90p pd=38u as=90p ps=38u
M1060 vdd a_2237_700# a4 w_2262_681# CMOSP w=20 l=2
+  ad=0.18n pd=58u as=0.18n ps=58u
M1061 a_3709_404# p1 vdd w_3696_433# CMOSP w=20 l=2
+  ad=100p pd=50u as=100p ps=50u
M1062 s4 p4 a_1962_527# Gnd CMOSN w=10 l=2
+  ad=50p pd=30u as=50p ps=30u
M1063 s3 p3 a_2443_387# w_2531_553# CMOSP w=20 l=2
+  ad=100p pd=50u as=100p ps=50u
M1064 a_2989_527# a2 vdd w_2976_546# CMOSP w=20 l=2
+  ad=100p pd=50u as=100p ps=50u
M1065 a_2208_904# clk a_2241_893# w_2233_883# CMOSP w=20 l=2
+  ad=0.18n pd=58u as=0.18n ps=58u
M1066 b0 a0 p0 w_3986_553# CMOSP w=20 l=2
+  ad=100p pd=50u as=100p ps=50u
M1067 p0 a_3969_527# b0 Gnd CMOSN w=10 l=2
+  ad=50p pd=30u as=50p ps=30u
M1068 gnd clk a_2262_182# Gnd CMOSN w=10 l=2
+  ad=90p pd=38u as=90p ps=38u
M1069 gnd c0 a_4049_384# Gnd CMOSN w=20 l=2
+  ad=100p pd=50u as=100p ps=50u
M1070 gnd a_3006_391# c3 Gnd CMOSN w=10 l=2
+  ad=50p pd=30u as=50p ps=30u
M1071 a_3158_904# ain2 gnd Gnd CMOSN w=10 l=2
+  ad=90p pd=38u as=90p ps=38u
M1072 g3 a_2732_524# vdd w_2719_553# CMOSP w=20 l=2
+  ad=100p pd=50u as=100p ps=50u
M1073 a_3851_110# a_3859_254# a_3862_182# Gnd CMOSN w=10 l=2
+  ad=90p pd=38u as=90p ps=38u
M1074 a_4018_420# g0 a_3986_391# w_3975_413# CMOSP w=40 l=2
+  ad=0.2n pd=90u as=0.2n ps=90u
M1075 a_2987_905# clk a_3020_894# w_3012_884# CMOSP w=20 l=2
+  ad=0.18n pd=58u as=0.18n ps=58u
M1076 vdd a_2066_701# b4 w_2091_682# CMOSP w=20 l=2
+  ad=0.18n pd=58u as=0.18n ps=58u
M1077 vdd a_3187_700# a2 w_3212_681# CMOSP w=20 l=2
+  ad=0.18n pd=58u as=0.18n ps=58u
M1078 b4 a4 p4 w_2091_553# CMOSP w=20 l=2
+  ad=100p pd=50u as=100p ps=50u
M1079 p4 a_2074_527# b4 Gnd CMOSN w=10 l=2
+  ad=50p pd=30u as=50p ps=30u
M1080 vdd a_2443_387# a_2398_426# w_2355_419# CMOSP w=40 l=2
+  ad=0.2n pd=90u as=0.2n ps=90u
M1081 a_2366_397# gB gnd Gnd CMOSN w=10 l=2
+  ad=50p pd=30u as=50p ps=30u
M1082 gnd clk a_3212_182# Gnd CMOSN w=10 l=2
+  ad=90p pd=38u as=90p ps=38u
M1083 a_2074_527# a4 vdd w_2061_546# CMOSP w=20 l=2
+  ad=100p pd=50u as=100p ps=50u
M1084 a_2180_524# b4 a_2173_524# Gnd CMOSN w=20 l=2
+  ad=100p pd=50u as=100p ps=50u
M1085 vdd a_3016_701# b2 w_3041_682# CMOSP w=20 l=2
+  ad=0.18n pd=58u as=0.18n ps=58u
M1086 a_2722_404# p2 gnd Gnd CMOSN w=20 l=2
+  ad=100p pd=50u as=100p ps=50u
M1087 a_2251_110# a_2259_254# a_2262_182# Gnd CMOSN w=10 l=2
+  ad=90p pd=38u as=90p ps=38u
M1088 p1 b1 a1 w_3623_553# CMOSP w=20 l=2
+  ad=100p pd=50u as=100p ps=50u
M1089 gnd a_3888_50# s0out Gnd CMOSN w=10 l=2
+  ad=90p pd=38u as=90p ps=38u
M1090 a_4058_904# ain0 gnd Gnd CMOSN w=10 l=2
+  ad=90p pd=38u as=90p ps=38u
M1091 a_3201_110# clk vdd w_3265_172# CMOSP w=20 l=2
+  ad=0.18n pd=58u as=0.18n ps=58u
M1092 vdd a_4087_700# a0 w_4112_681# CMOSP w=20 l=2
+  ad=0.18n pd=58u as=0.18n ps=58u
M1093 a_3862_112# a_3851_110# gnd Gnd CMOSN w=10 l=2
+  ad=90p pd=38u as=90p ps=38u
M1094 vdd bin4 a_2070_894# w_2062_884# CMOSP w=20 l=2
+  ad=0.18n pd=58u as=0.18n ps=58u
M1095 a_2514_527# a_2443_387# vdd w_2501_546# CMOSP w=20 l=2
+  ad=100p pd=50u as=100p ps=50u
M1096 p1 c1 s1 w_3511_553# CMOSP w=20 l=2
+  ad=100p pd=50u as=100p ps=50u
M1097 s1 a_3494_527# p1 Gnd CMOSN w=10 l=2
+  ad=50p pd=30u as=50p ps=30u
M1098 a_3494_527# c1 vdd w_3481_546# CMOSP w=20 l=2
+  ad=100p pd=50u as=100p ps=50u
M1099 a_3201_110# a_3209_254# a_3212_182# Gnd CMOSN w=10 l=2
+  ad=90p pd=38u as=90p ps=38u
M1100 gnd clk a_2562_182# Gnd CMOSN w=10 l=2
+  ad=90p pd=38u as=90p ps=38u
M1101 gnd g3 a_2549_386# Gnd CMOSN w=10 l=2
+  ad=50p pd=30u as=50p ps=30u
M1102 vdd a_2029_761# a_2066_701# w_2092_742# CMOSP w=20 l=2
+  ad=0.18n pd=58u as=0.18n ps=58u
M1103 vdd a3 a_2732_524# w_2719_553# CMOSP w=20 l=2
+  ad=100p pd=50u as=100p ps=50u
M1104 a_3712_524# b1 a_3705_524# Gnd CMOSN w=20 l=2
+  ad=100p pd=50u as=100p ps=50u
M1105 a_2262_112# a_2251_110# gnd Gnd CMOSN w=10 l=2
+  ad=90p pd=38u as=90p ps=38u
M1106 g2 a_3095_524# vdd w_3082_553# CMOSP w=20 l=2
+  ad=100p pd=50u as=100p ps=50u
M1107 gnd a_2588_50# cout Gnd CMOSN w=10 l=2
+  ad=90p pd=38u as=90p ps=38u
M1108 a_3862_112# clk a_3888_50# Gnd CMOSN w=10 l=2
+  ad=90p pd=38u as=90p ps=38u
M1109 a_2626_527# a3 gnd Gnd CMOSN w=10 l=2
+  ad=50p pd=30u as=50p ps=30u
M1110 a_3095_524# b2 vdd w_3082_553# CMOSP w=20 l=2
+  ad=100p pd=50u as=100p ps=50u
M1111 a_2173_419# g4 a_2141_390# w_2130_412# CMOSP w=40 l=2
+  ad=0.2n pd=90u as=0.2n ps=90u
M1112 gnd a_2443_387# a_2429_390# Gnd CMOSN w=20 l=2
+  ad=100p pd=50u as=100p ps=50u
M1113 gnd clk a_1962_182# Gnd CMOSN w=10 l=2
+  ad=90p pd=38u as=90p ps=38u
M1114 a_2534_761# clk vdd w_2598_823# CMOSP w=20 l=2
+  ad=0.18n pd=58u as=0.18n ps=58u
M1115 a_3606_527# a1 vdd w_3593_546# CMOSP w=20 l=2
+  ad=100p pd=50u as=100p ps=50u
M1116 a_3212_112# a_3201_110# gnd Gnd CMOSN w=10 l=2
+  ad=90p pd=38u as=90p ps=38u
M1117 a_2551_110# a_2559_254# a_2562_182# Gnd CMOSN w=10 l=2
+  ad=90p pd=38u as=90p ps=38u
M1118 p0 b0 a0 w_3986_553# CMOSP w=20 l=2
+  ad=100p pd=50u as=100p ps=50u
M1119 a_3038_420# p2 vdd w_2995_413# CMOSP w=40 l=2
+  ad=0.2n pd=90u as=0.2n ps=90u
M1120 gA a_3529_386# vdd w_3476_419# CMOSP w=20 l=2
+  ad=100p pd=50u as=100p ps=50u
M1121 vdd bin0 a_3920_894# w_3912_884# CMOSP w=20 l=2
+  ad=0.18n pd=58u as=0.18n ps=58u
M1122 a_2262_112# clk a_2288_50# Gnd CMOSN w=10 l=2
+  ad=90p pd=38u as=90p ps=38u
M1123 p2 C2 s2 w_2894_553# CMOSP w=20 l=2
+  ad=100p pd=50u as=100p ps=50u
M1124 s2 a_2877_527# p2 Gnd CMOSN w=10 l=2
+  ad=50p pd=30u as=50p ps=30u
M1125 vdd a_3201_110# a_3238_50# w_3264_91# CMOSP w=20 l=2
+  ad=0.18n pd=58u as=0.18n ps=58u
M1126 gnd a_3346_397# C2 Gnd CMOSN w=10 l=2
+  ad=50p pd=30u as=50p ps=30u
M1127 vdd ain3 a_2746_893# w_2738_883# CMOSP w=20 l=2
+  ad=0.18n pd=58u as=0.18n ps=58u
M1128 a_2877_527# C2 vdd w_2864_546# CMOSP w=20 l=2
+  ad=100p pd=50u as=100p ps=50u
M1129 gnd clk a_2912_182# Gnd CMOSN w=10 l=2
+  ad=90p pd=38u as=90p ps=38u
M1130 a_1951_110# clk vdd w_2015_172# CMOSP w=20 l=2
+  ad=0.18n pd=58u as=0.18n ps=58u
M1131 a_3006_391# g2 gnd Gnd CMOSN w=10 l=2
+  ad=50p pd=30u as=50p ps=30u
M1132 vdd a_3879_761# a_3916_701# w_3942_742# CMOSP w=20 l=2
+  ad=0.18n pd=58u as=0.18n ps=58u
M1133 a_1951_110# a_1959_254# a_1962_182# Gnd CMOSN w=10 l=2
+  ad=90p pd=38u as=90p ps=38u
M1134 vdd c0 a_4018_420# w_3975_413# CMOSP w=40 l=2
+  ad=0.2n pd=90u as=0.2n ps=90u
M1135 a_3434_761# clk vdd w_3498_823# CMOSP w=20 l=2
+  ad=0.18n pd=58u as=0.18n ps=58u
M1136 p4 b4 a4 w_2091_553# CMOSP w=20 l=2
+  ad=100p pd=50u as=100p ps=50u
M1137 gnd a_2938_50# s2out Gnd CMOSN w=10 l=2
+  ad=90p pd=38u as=90p ps=38u
M1138 a_3212_112# clk a_3238_50# Gnd CMOSN w=10 l=2
+  ad=90p pd=38u as=90p ps=38u
M1139 a_2545_763# a_2534_761# gnd Gnd CMOSN w=10 l=2
+  ad=90p pd=38u as=90p ps=38u
M1140 vdd a2 a_3095_524# w_3082_553# CMOSP w=20 l=2
+  ad=100p pd=50u as=100p ps=50u
M1141 vdd a_1988_50# s4out w_2013_31# CMOSP w=20 l=2
+  ad=0.18n pd=58u as=0.18n ps=58u
M1142 a_2562_112# a_2551_110# gnd Gnd CMOSN w=10 l=2
+  ad=90p pd=38u as=90p ps=38u
M1143 a_2901_110# clk vdd w_2965_172# CMOSP w=20 l=2
+  ad=0.18n pd=58u as=0.18n ps=58u
M1144 a_2716_762# a_2705_760# gnd Gnd CMOSN w=10 l=2
+  ad=90p pd=38u as=90p ps=38u
M1145 vdd a0 a_4075_524# w_4062_553# CMOSP w=20 l=2
+  ad=100p pd=50u as=100p ps=50u
M1146 a_4049_384# p0 a_4042_384# Gnd CMOSN w=20 l=2
+  ad=100p pd=50u as=100p ps=50u
M1147 a_2037_905# bin4 gnd Gnd CMOSN w=10 l=2
+  ad=90p pd=38u as=90p ps=38u
M1148 a_2208_904# ain4 gnd Gnd CMOSN w=10 l=2
+  ad=90p pd=38u as=90p ps=38u
M1149 gnd a_3916_701# b0 Gnd CMOSN w=10 l=2
+  ad=90p pd=38u as=90p ps=38u
M1150 a_2989_527# a2 gnd Gnd CMOSN w=10 l=2
+  ad=50p pd=30u as=50p ps=30u
M1151 a_2901_110# a_2909_254# a_2912_182# Gnd CMOSN w=10 l=2
+  ad=90p pd=38u as=90p ps=38u
M1152 vdd ain1 a_3646_893# w_3638_883# CMOSP w=20 l=2
+  ad=0.18n pd=58u as=0.18n ps=58u
M1153 a_3851_110# clk vdd w_3915_172# CMOSP w=20 l=2
+  ad=0.18n pd=58u as=0.18n ps=58u
M1154 a_2987_905# bin2 gnd Gnd CMOSN w=10 l=2
+  ad=90p pd=38u as=90p ps=38u
M1155 gnd clk a_3161_832# Gnd CMOSN w=10 l=2
+  ad=90p pd=38u as=90p ps=38u
M1156 vdd a_2705_760# a_2742_700# w_2768_741# CMOSP w=20 l=2
+  ad=0.18n pd=58u as=0.18n ps=58u
M1157 s1 p1 c1 w_3511_553# CMOSP w=20 l=2
+  ad=100p pd=50u as=100p ps=50u
M1158 a_3969_527# a0 vdd w_3956_546# CMOSP w=20 l=2
+  ad=100p pd=50u as=100p ps=50u
M1159 vdd g2 a_2509_426# w_2496_419# CMOSP w=40 l=2
+  ad=0.2n pd=90u as=0.2n ps=90u
M1160 a_3890_763# clk a_3916_701# Gnd CMOSN w=10 l=2
+  ad=90p pd=38u as=90p ps=38u
M1161 vdd a4 a_2180_524# w_2167_553# CMOSP w=20 l=2
+  ad=100p pd=50u as=100p ps=50u
M1162 g3 a_2732_524# gnd Gnd CMOSN w=10 l=2
+  ad=50p pd=30u as=50p ps=30u
M1163 a_2398_426# a_2423_413# vdd w_2355_419# CMOSP w=40 l=2
+  ad=0.2n pd=90u as=0.2n ps=90u
M1164 a_1962_112# a_1951_110# gnd Gnd CMOSN w=10 l=2
+  ad=90p pd=38u as=90p ps=38u
M1165 gnd a_3986_391# c1 Gnd CMOSN w=10 l=2
+  ad=50p pd=30u as=50p ps=30u
M1166 a_2545_763# clk a_2571_701# Gnd CMOSN w=10 l=2
+  ad=90p pd=38u as=90p ps=38u
M1167 a_3445_763# a_3434_761# gnd Gnd CMOSN w=10 l=2
+  ad=90p pd=38u as=90p ps=38u
M1168 s4 a_1962_527# p4 Gnd CMOSN w=10 l=2
+  ad=50p pd=30u as=50p ps=30u
M1169 a_2729_404# p3 a_2722_404# Gnd CMOSN w=20 l=2
+  ad=100p pd=50u as=100p ps=50u
M1170 a_2562_112# clk a_2588_50# Gnd CMOSN w=10 l=2
+  ad=90p pd=38u as=90p ps=38u
M1171 a_2716_762# clk a_2742_700# Gnd CMOSN w=10 l=2
+  ad=90p pd=38u as=90p ps=38u
M1172 a_3616_762# a_3605_760# gnd Gnd CMOSN w=10 l=2
+  ad=90p pd=38u as=90p ps=38u
M1173 p4 C4 s4 w_1979_553# CMOSP w=20 l=2
+  ad=100p pd=50u as=100p ps=50u
M1174 g1 a_3712_524# vdd w_3699_553# CMOSP w=20 l=2
+  ad=100p pd=50u as=100p ps=50u
M1175 a_2732_524# b3 vdd w_2719_553# CMOSP w=20 l=2
+  ad=100p pd=50u as=100p ps=50u
M1176 a_2251_110# clk vdd w_2315_172# CMOSP w=20 l=2
+  ad=0.18n pd=58u as=0.18n ps=58u
M1177 gnd a_2571_701# b3 Gnd CMOSN w=10 l=2
+  ad=90p pd=38u as=90p ps=38u
M1178 a_2074_527# a4 gnd Gnd CMOSN w=10 l=2
+  ad=50p pd=30u as=50p ps=30u
M1179 gnd a_2742_700# a3 Gnd CMOSN w=10 l=2
+  ad=90p pd=38u as=90p ps=38u
M1180 vdd a_3238_50# s1out w_3263_31# CMOSP w=20 l=2
+  ad=0.18n pd=58u as=0.18n ps=58u
M1181 a_2912_112# a_2901_110# gnd Gnd CMOSN w=10 l=2
+  ad=90p pd=38u as=90p ps=38u
M1182 vdd a_1951_110# a_1988_50# w_2014_91# CMOSP w=20 l=2
+  ad=0.18n pd=58u as=0.18n ps=58u
M1183 a_3346_397# gA gnd Gnd CMOSN w=10 l=2
+  ad=50p pd=30u as=50p ps=30u
M1184 a_3150_760# a_3158_904# a_3161_832# Gnd CMOSN w=10 l=2
+  ad=90p pd=38u as=90p ps=38u
M1185 gnd clk a_4061_832# Gnd CMOSN w=10 l=2
+  ad=90p pd=38u as=90p ps=38u
M1186 vdd a_3605_760# a_3642_700# w_3668_741# CMOSP w=20 l=2
+  ad=0.18n pd=58u as=0.18n ps=58u
M1187 vdd c1 a_3378_426# w_3335_419# CMOSP w=40 l=2
+  ad=0.2n pd=90u as=0.2n ps=90u
M1188 a_3887_905# bin0 gnd Gnd CMOSN w=10 l=2
+  ad=90p pd=38u as=90p ps=38u
M1189 a_1962_112# clk a_1988_50# Gnd CMOSN w=10 l=2
+  ad=90p pd=38u as=90p ps=38u
M1190 a_3702_404# p0 gnd Gnd CMOSN w=20 l=2
+  ad=100p pd=50u as=100p ps=50u
M1191 a_3887_905# clk a_3920_894# w_3912_884# CMOSP w=20 l=2
+  ad=0.18n pd=58u as=0.18n ps=58u
M1192 a_3445_763# clk a_3471_701# Gnd CMOSN w=10 l=2
+  ad=90p pd=38u as=90p ps=38u
M1193 vdd a_2901_110# a_2938_50# w_2964_91# CMOSP w=20 l=2
+  ad=0.18n pd=58u as=0.18n ps=58u
M1194 a_3616_762# clk a_3642_700# Gnd CMOSN w=10 l=2
+  ad=90p pd=38u as=90p ps=38u
M1195 a_2514_527# a_2443_387# gnd Gnd CMOSN w=10 l=2
+  ad=50p pd=30u as=50p ps=30u
M1196 a_3494_527# c1 gnd Gnd CMOSN w=10 l=2
+  ad=50p pd=30u as=50p ps=30u
M1197 gnd a_3471_701# b1 Gnd CMOSN w=10 l=2
+  ad=90p pd=38u as=90p ps=38u
M1198 s2 p2 C2 w_2894_553# CMOSP w=20 l=2
+  ad=100p pd=50u as=100p ps=50u
M1199 a_2525_390# g2 a_2509_390# Gnd CMOSN w=20 l=2
+  ad=100p pd=50u as=100p ps=50u
M1200 vdd s1 a_3242_243# w_3234_233# CMOSP w=20 l=2
+  ad=0.18n pd=58u as=0.18n ps=58u
M1201 gnd a_3642_700# a1 Gnd CMOSN w=10 l=2
+  ad=90p pd=38u as=90p ps=38u
M1202 s0 p0 c0 w_3874_553# CMOSP w=20 l=2
+  ad=100p pd=50u as=100p ps=50u
M1203 a_2429_390# a_2423_413# a_2422_390# Gnd CMOSN w=20 l=2
+  ad=100p pd=50u as=100p ps=50u
M1204 a_2912_112# clk a_2938_50# Gnd CMOSN w=10 l=2
+  ad=90p pd=38u as=90p ps=38u
M1205 a_4050_760# a_4058_904# a_4061_832# Gnd CMOSN w=10 l=2
+  ad=90p pd=38u as=90p ps=38u
M1206 vdd a_3916_701# b0 w_3941_682# CMOSP w=20 l=2
+  ad=0.18n pd=58u as=0.18n ps=58u
M1207 vdd a_2366_397# C4 w_2355_419# CMOSP w=20 l=2
+  ad=100p pd=50u as=100p ps=50u
M1208 vdd a_3851_110# a_3888_50# w_3914_91# CMOSP w=20 l=2
+  ad=0.18n pd=58u as=0.18n ps=58u
M1209 g2 a_3095_524# gnd Gnd CMOSN w=10 l=2
+  ad=50p pd=30u as=50p ps=30u
M1210 vdd a1 a_3712_524# w_3699_553# CMOSP w=20 l=2
+  ad=100p pd=50u as=100p ps=50u
M1211 gnd g1 a_3529_386# Gnd CMOSN w=10 l=2
+  ad=50p pd=30u as=50p ps=30u
M1212 a_2542_905# clk a_2575_894# w_2567_884# CMOSP w=20 l=2
+  ad=0.18n pd=58u as=0.18n ps=58u
M1213 vdd a_2742_700# a3 w_2767_681# CMOSP w=20 l=2
+  ad=0.18n pd=58u as=0.18n ps=58u
M1214 p3 b3 a_2626_527# Gnd CMOSN w=10 l=2
+  ad=50p pd=30u as=50p ps=30u
M1215 a_2713_904# clk a_2746_893# w_2738_883# CMOSP w=20 l=2
+  ad=0.18n pd=58u as=0.18n ps=58u
M1216 g0 a_4075_524# vdd w_4062_553# CMOSP w=20 l=2
+  ad=100p pd=50u as=100p ps=50u
M1217 a_2551_110# clk vdd w_2615_172# CMOSP w=20 l=2
+  ad=0.18n pd=58u as=0.18n ps=58u
M1218 s4 p4 C4 w_1979_553# CMOSP w=20 l=2
+  ad=100p pd=50u as=100p ps=50u
M1219 a_3606_527# a1 gnd Gnd CMOSN w=10 l=2
+  ad=50p pd=30u as=50p ps=30u
M1220 gnd a_1988_50# s4out Gnd CMOSN w=10 l=2
+  ad=90p pd=38u as=90p ps=38u
M1221 vdd a_2251_110# a_2288_50# w_2314_91# CMOSP w=20 l=2
+  ad=0.18n pd=58u as=0.18n ps=58u
M1222 gnd c1 a_3409_390# Gnd CMOSN w=20 l=2
+  ad=100p pd=50u as=100p ps=50u
M1223 a_4075_524# b0 vdd w_4062_553# CMOSP w=20 l=2
+  ad=100p pd=50u as=100p ps=50u
M1224 a_4018_420# p0 vdd w_3975_413# CMOSP w=40 l=2
+  ad=0.2n pd=90u as=0.2n ps=90u
M1225 a_3442_905# clk a_3475_894# w_3467_884# CMOSP w=20 l=2
+  ad=0.18n pd=58u as=0.18n ps=58u
M1226 vdd a_3642_700# a1 w_3667_681# CMOSP w=20 l=2
+  ad=0.18n pd=58u as=0.18n ps=58u
M1227 a_2877_527# C2 gnd Gnd CMOSN w=10 l=2
+  ad=50p pd=30u as=50p ps=30u
M1228 pB a_2729_404# vdd w_2716_433# CMOSP w=20 l=2
+  ad=100p pd=50u as=100p ps=50u
M1229 vdd bin3 a_2575_894# w_2567_884# CMOSP w=20 l=2
+  ad=0.18n pd=58u as=0.18n ps=58u
M1230 a_3613_904# clk a_3646_893# w_3638_883# CMOSP w=20 l=2
+  ad=0.18n pd=58u as=0.18n ps=58u
M1231 s0 a_3857_527# p0 Gnd CMOSN w=10 l=2
+  ad=50p pd=30u as=50p ps=30u
M1232 gB a_2549_386# gnd Gnd CMOSN w=10 l=2
+  ad=50p pd=30u as=50p ps=30u
M1233 a_3857_527# c0 vdd w_3844_546# CMOSP w=20 l=2
+  ad=100p pd=50u as=100p ps=50u
M1234 p0 c0 s0 w_3874_553# CMOSP w=20 l=2
+  ad=100p pd=50u as=100p ps=50u
M1235 vdd a_2288_50# s3out w_2313_31# CMOSP w=20 l=2
+  ad=0.18n pd=58u as=0.18n ps=58u
M1236 a_3986_391# g0 gnd Gnd CMOSN w=10 l=2
+  ad=50p pd=30u as=50p ps=30u
M1237 gnd clk a_2040_833# Gnd CMOSN w=10 l=2
+  ad=90p pd=38u as=90p ps=38u
M1238 g4 a_2180_524# vdd w_2167_553# CMOSP w=20 l=2
+  ad=100p pd=50u as=100p ps=50u
M1239 gnd clk a_2211_832# Gnd CMOSN w=10 l=2
+  ad=90p pd=38u as=90p ps=38u
M1240 a_2509_426# p3 vdd w_2496_419# CMOSP w=40 l=2
+  ad=0.2n pd=90u as=0.2n ps=90u
M1241 vdd s4 a_1992_243# w_1984_233# CMOSP w=20 l=2
+  ad=0.18n pd=58u as=0.18n ps=58u
M1242 a_3859_254# clk a_3892_243# w_3884_233# CMOSP w=20 l=2
+  ad=0.18n pd=58u as=0.18n ps=58u
M1243 a_1962_527# C4 vdd w_1949_546# CMOSP w=20 l=2
+  ad=100p pd=50u as=100p ps=50u
M1244 a_2180_524# b4 vdd w_2167_553# CMOSP w=20 l=2
+  ad=100p pd=50u as=100p ps=50u
M1245 p2 b2 a_2989_527# Gnd CMOSN w=10 l=2
+  ad=50p pd=30u as=50p ps=30u
M1246 vdd p2 a_2729_404# w_2716_433# CMOSP w=20 l=2
+  ad=100p pd=50u as=100p ps=50u
M1247 a_3489_426# p1 vdd w_3476_419# CMOSP w=40 l=2
+  ad=0.2n pd=90u as=0.2n ps=90u
M1248 vdd bin1 a_3475_894# w_3467_884# CMOSP w=20 l=2
+  ad=0.18n pd=58u as=0.18n ps=58u
M1249 gnd clk a_2990_833# Gnd CMOSN w=10 l=2
+  ad=90p pd=38u as=90p ps=38u
M1250 a_2200_760# clk vdd w_2264_822# CMOSP w=20 l=2
+  ad=0.18n pd=58u as=0.18n ps=58u
M1251 vdd a_2534_761# a_2571_701# w_2597_742# CMOSP w=20 l=2
+  ad=0.18n pd=58u as=0.18n ps=58u
M1252 a_3969_527# a0 gnd Gnd CMOSN w=10 l=2
+  ad=50p pd=30u as=50p ps=30u
M1253 vdd a_2551_110# a_2588_50# w_2614_91# CMOSP w=20 l=2
+  ad=0.18n pd=58u as=0.18n ps=58u
M1254 vdd s2 a_2942_243# w_2934_233# CMOSP w=20 l=2
+  ad=0.18n pd=58u as=0.18n ps=58u
M1255 vdd a_3006_391# c3 w_2995_413# CMOSP w=20 l=2
+  ad=100p pd=50u as=100p ps=50u
M1256 a_2259_254# clk a_2292_243# w_2284_233# CMOSP w=20 l=2
+  ad=0.18n pd=58u as=0.18n ps=58u
M1257 vdd g0 a_3489_426# w_3476_419# CMOSP w=40 l=2
+  ad=0.2n pd=90u as=0.2n ps=90u
M1258 a_2200_760# a_2208_904# a_2211_832# Gnd CMOSN w=10 l=2
+  ad=90p pd=38u as=90p ps=38u
M1259 a_2979_761# clk vdd w_3043_823# CMOSP w=20 l=2
+  ad=0.18n pd=58u as=0.18n ps=58u
M1260 g1 a_3712_524# gnd Gnd CMOSN w=10 l=2
+  ad=50p pd=30u as=50p ps=30u
M1261 a_3150_760# clk vdd w_3214_822# CMOSP w=20 l=2
+  ad=0.18n pd=58u as=0.18n ps=58u
M1262 a_3378_426# a_3403_413# vdd w_3335_419# CMOSP w=40 l=2
+  ad=0.2n pd=90u as=0.2n ps=90u
M1263 vdd s0 a_3892_243# w_3884_233# CMOSP w=20 l=2
+  ad=0.18n pd=58u as=0.18n ps=58u
M1264 a_3709_404# p1 a_3702_404# Gnd CMOSN w=20 l=2
+  ad=100p pd=50u as=100p ps=50u
M1265 gnd clk a_3890_833# Gnd CMOSN w=10 l=2
+  ad=90p pd=38u as=90p ps=38u
M1266 a_3209_254# clk a_3242_243# w_3234_233# CMOSP w=20 l=2
+  ad=0.18n pd=58u as=0.18n ps=58u
M1267 a_2029_761# a_2037_905# a_2040_833# Gnd CMOSN w=10 l=2
+  ad=90p pd=38u as=90p ps=38u
M1268 vdd a_3434_761# a_3471_701# w_3497_742# CMOSP w=20 l=2
+  ad=0.18n pd=58u as=0.18n ps=58u
M1269 a_3712_524# b1 vdd w_3699_553# CMOSP w=20 l=2
+  ad=100p pd=50u as=100p ps=50u
M1270 s3 p3 a_2514_527# Gnd CMOSN w=10 l=2
+  ad=50p pd=30u as=50p ps=30u
M1271 a_2141_390# g4 gnd Gnd CMOSN w=10 l=2
+  ad=50p pd=30u as=50p ps=30u
M1272 a_2509_390# p3 gnd Gnd CMOSN w=20 l=2
+  ad=100p pd=50u as=100p ps=50u
M1273 vdd s3 a_2292_243# w_2284_233# CMOSP w=20 l=2
+  ad=0.18n pd=58u as=0.18n ps=58u
M1274 a_2542_905# bin3 gnd Gnd CMOSN w=10 l=2
+  ad=90p pd=38u as=90p ps=38u
M1275 a_3489_390# p1 gnd Gnd CMOSN w=20 l=2
+  ad=100p pd=50u as=100p ps=50u
M1276 a_2713_904# ain3 gnd Gnd CMOSN w=10 l=2
+  ad=90p pd=38u as=90p ps=38u
M1277 a_2398_426# gB a_2366_397# w_2355_419# CMOSP w=40 l=2
+  ad=0.2n pd=90u as=0.2n ps=90u
M1278 a_2979_761# a_2987_905# a_2990_833# Gnd CMOSN w=10 l=2
+  ad=90p pd=38u as=90p ps=38u
M1279 a_4050_760# clk vdd w_4114_822# CMOSP w=20 l=2
+  ad=0.18n pd=58u as=0.18n ps=58u
M1280 a_3161_762# a_3150_760# gnd Gnd CMOSN w=10 l=2
+  ad=90p pd=38u as=90p ps=38u
M1281 p3 a_2626_527# b3 Gnd CMOSN w=10 l=2
+  ad=50p pd=30u as=50p ps=30u
M1282 vdd a_3888_50# s0out w_3913_31# CMOSP w=20 l=2
+  ad=0.18n pd=58u as=0.18n ps=58u
M1283 a_3505_390# g0 a_3489_390# Gnd CMOSN w=20 l=2
+  ad=100p pd=50u as=100p ps=50u
M1284 b3 a3 p3 w_2643_553# CMOSP w=20 l=2
+  ad=100p pd=50u as=100p ps=50u
M1285 vdd C4 a_2173_419# w_2130_412# CMOSP w=40 l=2
+  ad=0.2n pd=90u as=0.2n ps=90u
M1286 a_2559_254# clk a_2592_243# w_2584_233# CMOSP w=20 l=2
+  ad=0.18n pd=58u as=0.18n ps=58u
M1287 vdd a_2571_701# b3 w_2596_682# CMOSP w=20 l=2
+  ad=0.18n pd=58u as=0.18n ps=58u
M1288 vdd a_3346_397# C2 w_3335_419# CMOSP w=20 l=2
+  ad=100p pd=50u as=100p ps=50u
M1289 a_3409_390# a_3403_413# a_3402_390# Gnd CMOSN w=20 l=2
+  ad=100p pd=50u as=100p ps=50u
M1290 g0 a_4075_524# gnd Gnd CMOSN w=10 l=2
+  ad=50p pd=30u as=50p ps=30u
M1291 a_3442_905# bin1 gnd Gnd CMOSN w=10 l=2
+  ad=90p pd=38u as=90p ps=38u
M1292 p1 b1 a_3606_527# Gnd CMOSN w=10 l=2
+  ad=50p pd=30u as=50p ps=30u
M1293 a_3613_904# ain1 gnd Gnd CMOSN w=10 l=2
+  ad=90p pd=38u as=90p ps=38u
M1294 a_3161_762# clk a_3187_700# Gnd CMOSN w=10 l=2
+  ad=90p pd=38u as=90p ps=38u
M1295 a_4061_762# a_4050_760# gnd Gnd CMOSN w=10 l=2
+  ad=90p pd=38u as=90p ps=38u
M1296 a_2725_524# a3 gnd Gnd CMOSN w=20 l=2
+  ad=100p pd=50u as=100p ps=50u
M1297 a_2549_386# g3 a_2509_426# w_2496_419# CMOSP w=40 l=2
+  ad=0.2n pd=90u as=0.2n ps=90u
M1298 a_1959_254# clk a_1992_243# w_1984_233# CMOSP w=20 l=2
+  ad=0.18n pd=58u as=0.18n ps=58u
M1299 gnd a_3187_700# a2 Gnd CMOSN w=10 l=2
+  ad=90p pd=38u as=90p ps=38u
M1300 vdd a_2136_393# a_2592_243# w_2584_233# CMOSP w=20 l=2
+  ad=0.18n pd=58u as=0.18n ps=58u
M1301 pB a_2729_404# gnd Gnd CMOSN w=10 l=2
+  ad=50p pd=30u as=50p ps=30u
M1302 vdd a_2588_50# cout w_2613_31# CMOSP w=20 l=2
+  ad=0.18n pd=58u as=0.18n ps=58u
M1303 vdd a_3471_701# b1 w_3496_682# CMOSP w=20 l=2
+  ad=0.18n pd=58u as=0.18n ps=58u
M1304 gnd a_2141_390# a_2136_393# Gnd CMOSN w=10 l=2
+  ad=50p pd=30u as=50p ps=30u
M1305 a_3095_524# b2 a_3088_524# Gnd CMOSN w=20 l=2
+  ad=100p pd=50u as=100p ps=50u
M1306 a_3857_527# c0 gnd Gnd CMOSN w=10 l=2
+  ad=50p pd=30u as=50p ps=30u
M1307 gnd a_3238_50# s1out Gnd CMOSN w=10 l=2
+  ad=90p pd=38u as=90p ps=38u
M1308 a_2909_254# clk a_2942_243# w_2934_233# CMOSP w=20 l=2
+  ad=0.18n pd=58u as=0.18n ps=58u
M1309 pA a_3709_404# vdd w_3696_433# CMOSP w=20 l=2
+  ad=100p pd=50u as=100p ps=50u
M1310 a_4061_762# clk a_4087_700# Gnd CMOSN w=10 l=2
+  ad=90p pd=38u as=90p ps=38u
M1311 g4 a_2180_524# gnd Gnd CMOSN w=10 l=2
+  ad=50p pd=30u as=50p ps=30u
M1312 a_2729_404# p3 vdd w_2716_433# CMOSP w=20 l=2
+  ad=100p pd=50u as=100p ps=50u
M1313 gnd C4 a_2204_383# Gnd CMOSN w=20 l=2
+  ad=100p pd=50u as=100p ps=50u
M1314 gA a_3529_386# gnd Gnd CMOSN w=10 l=2
+  ad=50p pd=30u as=50p ps=30u
M1315 p2 a_2989_527# b2 Gnd CMOSN w=10 l=2
+  ad=50p pd=30u as=50p ps=30u
M1316 a_3859_254# s0 gnd Gnd CMOSN w=10 l=2
+  ad=90p pd=38u as=90p ps=38u
M1317 b2 a2 p2 w_3006_553# CMOSP w=20 l=2
+  ad=100p pd=50u as=100p ps=50u
M1318 gnd C2 a_3069_384# Gnd CMOSN w=20 l=2
+  ad=100p pd=50u as=100p ps=50u
M1319 gnd a_4087_700# a0 Gnd CMOSN w=10 l=2
+  ad=90p pd=38u as=90p ps=38u
M1320 a_1962_527# C4 gnd Gnd CMOSN w=10 l=2
+  ad=50p pd=30u as=50p ps=30u
M1321 a_3038_420# g2 a_3006_391# w_2995_413# CMOSP w=40 l=2
+  ad=0.2n pd=90u as=0.2n ps=90u
M1322 a_2029_761# clk vdd w_2093_823# CMOSP w=20 l=2
+  ad=0.18n pd=58u as=0.18n ps=58u
M1323 p0 b0 a_3969_527# Gnd CMOSN w=10 l=2
+  ad=50p pd=30u as=50p ps=30u
M1324 a_2259_254# s3 gnd Gnd CMOSN w=10 l=2
+  ad=90p pd=38u as=90p ps=38u
M1325 vdd p0 a_3709_404# w_3696_433# CMOSP w=20 l=2
+  ad=100p pd=50u as=100p ps=50u
M1326 a_3158_904# clk a_3191_893# w_3183_883# CMOSP w=20 l=2
+  ad=0.18n pd=58u as=0.18n ps=58u
M1327 a_3088_524# a2 gnd Gnd CMOSN w=20 l=2
+  ad=100p pd=50u as=100p ps=50u
M1328 a_4068_524# a0 gnd Gnd CMOSN w=20 l=2
+  ad=100p pd=50u as=100p ps=50u
M1329 vdd a_3986_391# c1 w_3975_413# CMOSP w=20 l=2
+  ad=100p pd=50u as=100p ps=50u
M1330 p3 b3 a3 w_2643_553# CMOSP w=20 l=2
+  ad=100p pd=50u as=100p ps=50u
M1331 vdd ain4 a_2241_893# w_2233_883# CMOSP w=20 l=2
+  ad=0.18n pd=58u as=0.18n ps=58u
M1332 p4 b4 a_2074_527# Gnd CMOSN w=10 l=2
+  ad=50p pd=30u as=50p ps=30u
M1333 a_3209_254# s1 gnd Gnd CMOSN w=10 l=2
+  ad=90p pd=38u as=90p ps=38u
C0 b0 a_3969_527# 0.1137f
C1 p0 c1 0.00188f
C2 a_3095_524# a_3088_524# 0.2065f
C3 p1 s1 0.48573f
C4 a_3892_243# clk 0.09719f
C5 a_1951_110# vdd 0.29338f
C6 gnd a_3346_397# 0.20007f
C7 vdd a_3986_391# 0.04199f
C8 gnd b3 0.11686f
C9 vdd b0 0.27038f
C10 C4 w_2130_412# 0.02139f
C11 gnd ain0 0.34454f
C12 clk a_2029_761# 0.40596f
C13 vdd a_2200_760# 0.29338f
C14 a_3209_254# a_3212_182# 0.08667f
C15 vdd w_3941_682# 0.07131f
C16 a_1959_254# s4 0.14109f
C17 c1 gA 0.0168f
C18 a_3857_527# s0 0.2394f
C19 g3 a_2509_426# 0.00296f
C20 s1out gnd 0.11686f
C21 b2 p2 0.48573f
C22 gnd g2 0.59844f
C23 vdd g1 0.25103f
C24 a_3879_761# a_3916_701# 0.07571f
C25 g0 w_3476_419# 0.06199f
C26 a_2141_390# w_2130_412# 0.0306f
C27 gnd a_3445_763# 0.06873f
C28 clk a_3187_700# 0.09719f
C29 vdd a_3471_701# 0.19716f
C30 a_2912_112# a_2938_50# 0.06873f
C31 a0 w_4112_681# 0.01842f
C32 w_2963_31# vdd 0.07131f
C33 a_3879_761# w_3942_742# 0.09286f
C34 a_3489_390# a_3505_390# 0.20619f
C35 vdd w_3696_433# 0.11088f
C36 a_3892_243# s0 0.08635f
C37 g0 a_3489_426# 0.13272f
C38 a_2729_404# pB 0.06543f
C39 clk w_2062_884# 0.07242f
C40 vdd w_2233_883# 0.07062f
C41 a0 c0 0.00147f
C42 a_2443_387# s3 0.41371f
C43 b1 a_3705_524# 0.05572f
C44 a_2909_254# gnd 0.16501f
C45 a_2592_243# clk 0.09719f
C46 a_2942_243# vdd 0.19523f
C47 a_2942_243# w_2934_233# 0.04299f
C48 vdd a_3529_386# 0.04199f
C49 gnd a_2722_404# 0.44789f
C50 a_3434_761# a_3445_763# 0.09719f
C51 gnd a_4087_700# 0.0984f
C52 vdd a2 0.57465f
C53 a_2877_527# w_2864_546# 0.00918f
C54 C2 w_2894_553# 0.06079f
C55 p2 w_2716_433# 0.04579f
C56 gnd a_3887_905# 0.16501f
C57 bin2 a_3020_894# 0.08635f
C58 ain2 a_3158_904# 0.14109f
C59 clk a_3646_893# 0.09719f
C60 vdd a_3920_894# 0.19523f
C61 a_3646_893# w_3638_883# 0.04299f
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
