munchsubal/5-bit-cla/post_layout_stuff/five_bit_ckt.sp

* 5 bit CLA

.include ../spice/tech/TSMC_180nm.txt

.option scale=90n

* Supply and MOSFET parameters
.param SUPPLY = 1.8

* Voltage Sources
Vdd vdd gnd 1.8
Va0 a0 gnd 1.8
Va1 a1 gnd 1.8
Va2 a2 gnd 1.8
Va3 a3 gnd 1.8
Va4 a4 gnd 0
Vb0 b0 gnd 0
Vb1 b1 gnd 0
Vb2 b2 gnd 0
Vb3 b3 gnd 0
Vb4 b4 gnd pulse(0 1.8 0.45n 0 0 1n 2n)
Vc0 c0 gnd 0

M1000 a_229_22# a0 gnd Gnd CMOSN w=20 l=2
+  ad=100p pd=50u as=100p ps=50u
M1001 a_n1110_n98# p3 a_n1117_n98# Gnd CMOSN w=20 l=2
+  ad=100p pd=50u as=100p ps=50u
M1002 p0 b0 a_130_25# Gnd CMOSN w=10 l=2
+  ad=50p pd=30u as=50p ps=30u
M1003 a_n134_22# a1 gnd Gnd CMOSN w=20 l=2
+  ad=100p pd=50u as=100p ps=50u
M1004 gA a_n310_n116# gnd Gnd CMOSN w=10 l=2
+  ad=50p pd=30u as=50p ps=30u
M1005 a_n461_n76# gA a_n493_n105# w_n504_n83# CMOSP w=40 l=2
+  ad=0.2n pd=90u as=0.2n ps=90u
M1006 vdd c3 a_n1441_n76# w_n1484_n83# CMOSP w=40 l=2
+  ad=0.2n pd=90u as=0.2n ps=90u
M1007 s3 p3 c3 w_n1308_51# CMOSP w=20 l=2
+  ad=100p pd=50u as=100p ps=50u
M1008 a_n744_22# b2 vdd w_n757_51# CMOSP w=20 l=2
+  ad=100p pd=50u as=100p ps=50u
M1009 a_n801_n82# p2 vdd w_n844_n89# CMOSP w=40 l=2
+  ad=0.2n pd=90u as=0.2n ps=90u
M1010 g1 a_n127_22# gnd Gnd CMOSN w=10 l=2
+  ad=50p pd=30u as=50p ps=30u
M1011 a_n233_25# a1 gnd Gnd CMOSN w=10 l=2
+  ad=50p pd=30u as=50p ps=30u
M1012 a_n1666_22# a4 gnd Gnd CMOSN w=20 l=2
+  ad=100p pd=50u as=100p ps=50u
M1013 s2 a_n962_25# p2 Gnd CMOSN w=10 l=2
+  ad=50p pd=30u as=50p ps=30u
M1014 a_n1330_n112# p3 gnd Gnd CMOSN w=20 l=2
+  ad=100p pd=50u as=100p ps=50u
M1015 a_n1441_n76# a_n1416_n89# vdd w_n1484_n83# CMOSP w=40 l=2
+  ad=0.2n pd=90u as=0.2n ps=90u
M1016 p3 b3 a_n1213_25# Gnd CMOSN w=10 l=2
+  ad=50p pd=30u as=50p ps=30u
M1017 vdd g2 a_n1330_n76# w_n1343_n83# CMOSP w=40 l=2
+  ad=0.2n pd=90u as=0.2n ps=90u
M1018 g0 a_236_22# gnd Gnd CMOSN w=10 l=2
+  ad=50p pd=30u as=50p ps=30u
M1019 a_n1765_25# a4 gnd Gnd CMOSN w=10 l=2
+  ad=50p pd=30u as=50p ps=30u
M1020 p1 c1 s1 w_n328_51# CMOSP w=20 l=2
+  ad=100p pd=50u as=100p ps=50u
M1021 a_n127_22# b1 vdd w_n140_51# CMOSP w=20 l=2
+  ad=100p pd=50u as=100p ps=50u
M1022 p0 b0 a0 w_147_51# CMOSP w=20 l=2
+  ad=100p pd=50u as=100p ps=50u
M1023 b2 a2 p2 w_n833_51# CMOSP w=20 l=2
+  ad=100p pd=50u as=100p ps=50u
M1024 vdd a1 a_n127_22# w_n140_51# CMOSP w=20 l=2
+  ad=100p pd=50u as=100p ps=50u
M1025 vdd a0 a_236_22# w_223_51# CMOSP w=20 l=2
+  ad=100p pd=50u as=100p ps=50u
M1026 a_n1325_25# c3 vdd w_n1338_44# CMOSP w=20 l=2
+  ad=100p pd=50u as=100p ps=50u
M1027 vdd a_n1698_n112# cout w_n1709_n90# CMOSP w=20 l=2
+  ad=100p pd=50u as=100p ps=50u
M1028 s1 a_n345_25# p1 Gnd CMOSN w=10 l=2
+  ad=50p pd=30u as=50p ps=30u
M1029 gB a_n1290_n116# vdd w_n1343_n83# CMOSP w=20 l=2
+  ad=100p pd=50u as=100p ps=50u
M1030 p3 b3 a3 w_n1196_51# CMOSP w=20 l=2
+  ad=100p pd=50u as=100p ps=50u
M1031 g2 a_n744_22# vdd w_n757_51# CMOSP w=20 l=2
+  ad=100p pd=50u as=100p ps=50u
M1032 vdd a4 a_n1659_22# w_n1672_51# CMOSP w=20 l=2
+  ad=100p pd=50u as=100p ps=50u
M1033 a_n430_n112# a_n436_n89# a_n437_n112# Gnd CMOSN w=20 l=2
+  ad=100p pd=50u as=100p ps=50u
M1034 a_130_25# a0 vdd w_117_44# CMOSP w=20 l=2
+  ad=100p pd=50u as=100p ps=50u
M1035 a_n310_n116# g1 a_n350_n76# w_n363_n83# CMOSP w=40 l=2
+  ad=0.2n pd=90u as=0.2n ps=90u
M1036 p2 a_n850_25# b2 Gnd CMOSN w=10 l=2
+  ad=50p pd=30u as=50p ps=30u
M1037 b1 a1 p1 w_n216_51# CMOSP w=20 l=2
+  ad=100p pd=50u as=100p ps=50u
M1038 gB a_n1290_n116# gnd Gnd CMOSN w=10 l=2
+  ad=50p pd=30u as=50p ps=30u
M1039 gnd c3 a_n1410_n112# Gnd CMOSN w=20 l=2
+  ad=100p pd=50u as=100p ps=50u
M1040 b4 a4 p4 w_n1748_51# CMOSP w=20 l=2
+  ad=100p pd=50u as=100p ps=50u
M1041 vdd C2 a_n801_n82# w_n844_n89# CMOSP w=40 l=2
+  ad=0.2n pd=90u as=0.2n ps=90u
M1042 vdd a_n493_n105# C2 w_n504_n83# CMOSP w=20 l=2
+  ad=100p pd=50u as=100p ps=50u
M1043 gnd C4 a_n1635_n119# Gnd CMOSN w=20 l=2
+  ad=100p pd=50u as=100p ps=50u
M1044 vdd c0 a_179_n82# w_136_n89# CMOSP w=40 l=2
+  ad=0.2n pd=90u as=0.2n ps=90u
M1045 s2 p2 a_n962_25# Gnd CMOSN w=10 l=2
+  ad=50p pd=30u as=50p ps=30u
M1046 a_n770_n118# p2 a_n777_n118# Gnd CMOSN w=20 l=2
+  ad=100p pd=50u as=100p ps=50u
M1047 a_n1213_25# a3 vdd w_n1226_44# CMOSP w=20 l=2
+  ad=100p pd=50u as=100p ps=50u
M1048 gnd a_n833_n111# c3 Gnd CMOSN w=10 l=2
+  ad=50p pd=30u as=50p ps=30u
M1049 g3 a_n1107_22# gnd Gnd CMOSN w=10 l=2
+  ad=50p pd=30u as=50p ps=30u
M1050 pA a_n130_n98# vdd w_n143_n69# CMOSP w=20 l=2
+  ad=100p pd=50u as=100p ps=50u
M1051 p1 a_n233_25# b1 Gnd CMOSN w=10 l=2
+  ad=50p pd=30u as=50p ps=30u
M1052 pB a_n1110_n98# gnd Gnd CMOSN w=10 l=2
+  ad=50p pd=30u as=50p ps=30u
M1053 p4 a_n1765_25# b4 Gnd CMOSN w=10 l=2
+  ad=50p pd=30u as=50p ps=30u
M1054 gnd c0 a_210_n118# Gnd CMOSN w=20 l=2
+  ad=100p pd=50u as=100p ps=50u
M1055 g4 a_n1659_22# gnd Gnd CMOSN w=10 l=2
+  ad=50p pd=30u as=50p ps=30u
M1056 s1 p1 a_n345_25# Gnd CMOSN w=10 l=2
+  ad=50p pd=30u as=50p ps=30u
M1057 a_n751_22# a2 gnd Gnd CMOSN w=20 l=2
+  ad=100p pd=50u as=100p ps=50u
M1058 s0 a_18_25# p0 Gnd CMOSN w=10 l=2
+  ad=50p pd=30u as=50p ps=30u
M1059 a_n493_n105# gA gnd Gnd CMOSN w=10 l=2
+  ad=50p pd=30u as=50p ps=30u
M1060 gnd g3 a_n1290_n116# Gnd CMOSN w=10 l=2
+  ad=50p pd=30u as=50p ps=30u
M1061 a_n350_n76# p1 vdd w_n363_n83# CMOSP w=40 l=2
+  ad=0.2n pd=90u as=0.2n ps=90u
M1062 a_n1325_25# c3 gnd Gnd CMOSN w=10 l=2
+  ad=50p pd=30u as=50p ps=30u
M1063 a_n334_n112# g0 a_n350_n112# Gnd CMOSN w=20 l=2
+  ad=100p pd=50u as=100p ps=50u
M1064 a_n1290_n116# g3 a_n1330_n76# w_n1343_n83# CMOSP w=40 l=2
+  ad=0.2n pd=90u as=0.2n ps=90u
M1065 s2 p2 C2 w_n945_51# CMOSP w=20 l=2
+  ad=100p pd=50u as=100p ps=50u
M1066 a_n1410_n112# a_n1416_n89# a_n1417_n112# Gnd CMOSN w=20 l=2
+  ad=100p pd=50u as=100p ps=50u
M1067 s4 p4 a_n1877_25# Gnd CMOSN w=10 l=2
+  ad=50p pd=30u as=50p ps=30u
M1068 s0 p0 a_18_25# Gnd CMOSN w=10 l=2
+  ad=50p pd=30u as=50p ps=30u
M1069 a_n1635_n119# p4 a_n1642_n119# Gnd CMOSN w=20 l=2
+  ad=100p pd=50u as=100p ps=50u
M1070 a_130_25# a0 gnd Gnd CMOSN w=10 l=2
+  ad=50p pd=30u as=50p ps=30u
M1071 p2 b2 a_n850_25# Gnd CMOSN w=10 l=2
+  ad=50p pd=30u as=50p ps=30u
M1072 gnd a_n493_n105# C2 Gnd CMOSN w=10 l=2
+  ad=50p pd=30u as=50p ps=30u
M1073 a_n130_n98# p1 vdd w_n143_n69# CMOSP w=20 l=2
+  ad=100p pd=50u as=100p ps=50u
M1074 a_n1107_22# b3 a_n1114_22# Gnd CMOSN w=20 l=2
+  ad=100p pd=50u as=100p ps=50u
M1075 a_n1441_n76# gB a_n1473_n105# w_n1484_n83# CMOSP w=40 l=2
+  ad=0.2n pd=90u as=0.2n ps=90u
M1076 s1 p1 c1 w_n328_51# CMOSP w=20 l=2
+  ad=100p pd=50u as=100p ps=50u
M1077 a_236_22# b0 a_229_22# Gnd CMOSN w=20 l=2
+  ad=100p pd=50u as=100p ps=50u
M1078 g1 a_n127_22# vdd w_n140_51# CMOSP w=20 l=2
+  ad=100p pd=50u as=100p ps=50u
M1079 a_179_n82# p0 vdd w_136_n89# CMOSP w=40 l=2
+  ad=0.2n pd=90u as=0.2n ps=90u
M1080 gnd a_147_n111# c1 Gnd CMOSN w=10 l=2
+  ad=50p pd=30u as=50p ps=30u
M1081 a_n1666_n83# p4 vdd w_n1709_n90# CMOSP w=40 l=2
+  ad=0.2n pd=90u as=0.2n ps=90u
M1082 p1 b1 a_n233_25# Gnd CMOSN w=10 l=2
+  ad=50p pd=30u as=50p ps=30u
M1083 g0 a_236_22# vdd w_223_51# CMOSP w=20 l=2
+  ad=100p pd=50u as=100p ps=50u
M1084 b0 a0 p0 w_147_51# CMOSP w=20 l=2
+  ad=100p pd=50u as=100p ps=50u
M1085 vdd a2 a_n744_22# w_n757_51# CMOSP w=20 l=2
+  ad=100p pd=50u as=100p ps=50u
M1086 s0 p0 c0 w_35_51# CMOSP w=20 l=2
+  ad=100p pd=50u as=100p ps=50u
M1087 s4 p4 C4 w_n1860_51# CMOSP w=20 l=2
+  ad=100p pd=50u as=100p ps=50u
M1088 a_n1659_22# b4 a_n1666_22# Gnd CMOSN w=20 l=2
+  ad=100p pd=50u as=100p ps=50u
M1089 a_n1114_22# a3 gnd Gnd CMOSN w=20 l=2
+  ad=100p pd=50u as=100p ps=50u
M1090 a_n130_n98# p1 a_n137_n98# Gnd CMOSN w=20 l=2
+  ad=100p pd=50u as=100p ps=50u
M1091 a_n833_n111# g2 gnd Gnd CMOSN w=10 l=2
+  ad=50p pd=30u as=50p ps=30u
M1092 a_n1213_25# a3 gnd Gnd CMOSN w=10 l=2
+  ad=50p pd=30u as=50p ps=30u
M1093 p2 b2 a2 w_n833_51# CMOSP w=20 l=2
+  ad=100p pd=50u as=100p ps=50u
M1094 p4 b4 a_n1765_25# Gnd CMOSN w=10 l=2
+  ad=50p pd=30u as=50p ps=30u
M1095 a_n962_25# C2 vdd w_n975_44# CMOSP w=20 l=2
+  ad=100p pd=50u as=100p ps=50u
M1096 vdd a_147_n111# c1 w_136_n89# CMOSP w=20 l=2
+  ad=100p pd=50u as=100p ps=50u
M1097 p3 c3 s3 w_n1308_51# CMOSP w=20 l=2
+  ad=100p pd=50u as=100p ps=50u
M1098 a_n1107_22# b3 vdd w_n1120_51# CMOSP w=20 l=2
+  ad=100p pd=50u as=100p ps=50u
M1099 a_n461_n76# a_n436_n89# vdd w_n504_n83# CMOSP w=40 l=2
+  ad=0.2n pd=90u as=0.2n ps=90u
M1100 a_n1473_n105# gB gnd Gnd CMOSN w=10 l=2
+  ad=50p pd=30u as=50p ps=30u
M1101 a_18_25# c0 vdd w_5_44# CMOSP w=20 l=2
+  ad=100p pd=50u as=100p ps=50u
M1102 vdd g0 a_n350_n76# w_n363_n83# CMOSP w=40 l=2
+  ad=0.2n pd=90u as=0.2n ps=90u
M1103 p1 b1 a1 w_n216_51# CMOSP w=20 l=2
+  ad=100p pd=50u as=100p ps=50u
M1104 a_n1314_n112# g2 a_n1330_n112# Gnd CMOSN w=20 l=2
+  ad=100p pd=50u as=100p ps=50u
M1105 a_236_22# b0 vdd w_223_51# CMOSP w=20 l=2
+  ad=100p pd=50u as=100p ps=50u
M1106 p4 C4 s4 w_n1860_51# CMOSP w=20 l=2
+  ad=100p pd=50u as=100p ps=50u
M1107 a_n345_25# c1 vdd w_n358_44# CMOSP w=20 l=2
+  ad=100p pd=50u as=100p ps=50u
M1108 s3 a_n1325_25# p3 Gnd CMOSN w=10 l=2
+  ad=50p pd=30u as=50p ps=30u
M1109 gnd a_n1473_n105# C4 Gnd CMOSN w=10 l=2
+  ad=50p pd=30u as=50p ps=30u
M1110 gnd a_n1698_n112# cout Gnd CMOSN w=10 l=2
+  ad=50p pd=30u as=50p ps=30u
M1111 p4 b4 a4 w_n1748_51# CMOSP w=20 l=2
+  ad=100p pd=50u as=100p ps=50u
M1112 a_n1659_22# b4 vdd w_n1672_51# CMOSP w=20 l=2
+  ad=100p pd=50u as=100p ps=50u
M1113 vdd a3 a_n1107_22# w_n1120_51# CMOSP w=20 l=2
+  ad=100p pd=50u as=100p ps=50u
M1114 vdd p0 a_n130_n98# w_n143_n69# CMOSP w=20 l=2
+  ad=100p pd=50u as=100p ps=50u
M1115 a_n1877_25# C4 vdd w_n1890_44# CMOSP w=20 l=2
+  ad=100p pd=50u as=100p ps=50u
M1116 a_n801_n82# g2 a_n833_n111# w_n844_n89# CMOSP w=40 l=2
+  ad=0.2n pd=90u as=0.2n ps=90u
M1117 vdd a_n1473_n105# C4 w_n1484_n83# CMOSP w=20 l=2
+  ad=100p pd=50u as=100p ps=50u
M1118 vdd C4 a_n1666_n83# w_n1709_n90# CMOSP w=40 l=2
+  ad=0.2n pd=90u as=0.2n ps=90u
M1119 s4 a_n1877_25# p4 Gnd CMOSN w=10 l=2
+  ad=50p pd=30u as=50p ps=30u
M1120 pA a_n130_n98# gnd Gnd CMOSN w=10 l=2
+  ad=50p pd=30u as=50p ps=30u
M1121 a_n850_25# a2 vdd w_n863_44# CMOSP w=20 l=2
+  ad=100p pd=50u as=100p ps=50u
M1122 g2 a_n744_22# gnd Gnd CMOSN w=10 l=2
+  ad=50p pd=30u as=50p ps=30u
M1123 gA a_n310_n116# vdd w_n363_n83# CMOSP w=20 l=2
+  ad=100p pd=50u as=100p ps=50u
M1124 b3 a3 p3 w_n1196_51# CMOSP w=20 l=2
+  ad=100p pd=50u as=100p ps=50u
M1125 g3 a_n1107_22# vdd w_n1120_51# CMOSP w=20 l=2
+  ad=100p pd=50u as=100p ps=50u
M1126 gnd c1 a_n430_n112# Gnd CMOSN w=20 l=2
+  ad=100p pd=50u as=100p ps=50u
M1127 a_n137_n98# p0 gnd Gnd CMOSN w=20 l=2
+  ad=100p pd=50u as=100p ps=50u
M1128 a_n233_25# a1 vdd w_n246_44# CMOSP w=20 l=2
+  ad=100p pd=50u as=100p ps=50u
M1129 g4 a_n1659_22# vdd w_n1672_51# CMOSP w=20 l=2
+  ad=100p pd=50u as=100p ps=50u
M1130 p3 a_n1213_25# b3 Gnd CMOSN w=10 l=2
+  ad=50p pd=30u as=50p ps=30u
M1131 a_n962_25# C2 gnd Gnd CMOSN w=10 l=2
+  ad=50p pd=30u as=50p ps=30u
M1132 a_179_n82# g0 a_147_n111# w_136_n89# CMOSP w=40 l=2
+  ad=0.2n pd=90u as=0.2n ps=90u
M1133 a_n350_n112# p1 gnd Gnd CMOSN w=20 l=2
+  ad=100p pd=50u as=100p ps=50u
M1134 vdd c1 a_n461_n76# w_n504_n83# CMOSP w=40 l=2
+  ad=0.2n pd=90u as=0.2n ps=90u
M1135 a_n1765_25# a4 vdd w_n1778_44# CMOSP w=20 l=2
+  ad=100p pd=50u as=100p ps=50u
M1136 a_n1330_n76# p3 vdd w_n1343_n83# CMOSP w=40 l=2
+  ad=0.2n pd=90u as=0.2n ps=90u
M1137 a_18_25# c0 gnd Gnd CMOSN w=10 l=2
+  ad=50p pd=30u as=50p ps=30u
M1138 gnd C2 a_n770_n118# Gnd CMOSN w=20 l=2
+  ad=100p pd=50u as=100p ps=50u
M1139 vdd p2 a_n1110_n98# w_n1123_n69# CMOSP w=20 l=2
+  ad=100p pd=50u as=100p ps=50u
M1140 a_n744_22# b2 a_n751_22# Gnd CMOSN w=20 l=2
+  ad=100p pd=50u as=100p ps=50u
M1141 a_n345_25# c1 gnd Gnd CMOSN w=10 l=2
+  ad=50p pd=30u as=50p ps=30u
M1142 a_n1110_n98# p3 vdd w_n1123_n69# CMOSP w=20 l=2
+  ad=100p pd=50u as=100p ps=50u
M1143 a_210_n118# p0 a_203_n118# Gnd CMOSN w=20 l=2
+  ad=100p pd=50u as=100p ps=50u
M1144 s3 p3 a_n1325_25# Gnd CMOSN w=10 l=2
+  ad=50p pd=30u as=50p ps=30u
M1145 gnd g1 a_n310_n116# Gnd CMOSN w=10 l=2
+  ad=50p pd=30u as=50p ps=30u
M1146 vdd a_n833_n111# c3 w_n844_n89# CMOSP w=20 l=2
+  ad=100p pd=50u as=100p ps=50u
M1147 a_n1698_n112# g4 gnd Gnd CMOSN w=10 l=2
+  ad=50p pd=30u as=50p ps=30u
M1148 pB a_n1110_n98# vdd w_n1123_n69# CMOSP w=20 l=2
+  ad=100p pd=50u as=100p ps=50u
M1149 a_n1666_n83# g4 a_n1698_n112# w_n1709_n90# CMOSP w=40 l=2
+  ad=0.2n pd=90u as=0.2n ps=90u
M1150 a_n1877_25# C4 gnd Gnd CMOSN w=10 l=2
+  ad=50p pd=30u as=50p ps=30u
M1151 p0 a_130_25# b0 Gnd CMOSN w=10 l=2
+  ad=50p pd=30u as=50p ps=30u
M1152 a_n127_22# b1 a_n134_22# Gnd CMOSN w=20 l=2
+  ad=100p pd=50u as=100p ps=50u
M1153 p0 c0 s0 w_35_51# CMOSP w=20 l=2
+  ad=100p pd=50u as=100p ps=50u
M1154 a_n1117_n98# p2 gnd Gnd CMOSN w=20 l=2
+  ad=100p pd=50u as=100p ps=50u
M1155 a_n850_25# a2 gnd Gnd CMOSN w=10 l=2
+  ad=50p pd=30u as=50p ps=30u
M1156 a_147_n111# g0 gnd Gnd CMOSN w=10 l=2
+  ad=50p pd=30u as=50p ps=30u
M1157 p2 C2 s2 w_n945_51# CMOSP w=20 l=2
+  ad=100p pd=50u as=100p ps=50u
C0 a_130_25# gnd 0.53199f
C1 a_n1117_n98# p3 0.05572f
C2 a_n436_n89# vdd 0.09844f
C3 a_n130_n98# w_n143_n69# 0.05806f
C4 gA a_n493_n105# 0.14085f
C5 vdd a_n850_25# 0.20619f
C6 gnd a_n1213_25# 0.53199f
C7 w_n833_51# p2 0.0253f
C8 w_n1890_44# vdd 0.01082f
C9 w_n1860_51# C4 0.06079f
C10 c0 s0 0.41371f
C11 b4 C4 0.00477f
C12 w_n844_n89# c3 0.00933f
C13 a2 a_n744_22# 0.10116f
C14 p4 vdd 0.3094f
C15 w_n358_44# a_n345_25# 0.00918f
C16 w_n328_51# c1 0.06079f
C17 a_n1416_n89# C4 0.0029f
C18 a_n350_n76# w_n363_n83# 0.04274f
C19 gB vdd 0.20981f
C20 a_n1666_n83# a_n1635_n119# 0.10997f
C21 p0 c1 0.00188f
C22 vdd a_n962_25# 0.20619f
C23 p1 a_n233_25# 0.2394f
C24 gnd a_n1325_25# 0.53199f
C25 c3 s3 0.41371f
C26 a_n493_n105# C2 0.05934f
C27 a_147_n111# gnd 0.20007f
C28 a_n461_n76# a_n430_n112# 0.10997f
C29 w_n363_n83# vdd 0.17236f
C30 p2 a2 0.4546f
C31 w_n1484_n83# c3 0.02141f
C32 w_n757_51# g2 0.00933f
C33 a_229_22# a_236_22# 0.2065f
C34 a_130_25# vdd 0.20619f
C35 a_n493_n105# w_n504_n83# 0.0306f
C36 a_n1416_n89# a_n1410_n112# 0
C37 g4 gnd 0.1968f
C38 b1 c1 0.00477f
C39 vdd a_n1213_25# 0.20619f
C40 a2 a_n751_22# 0.05572f
C41 p1 a_n345_25# 0.1137f
C42 w_n1120_51# a3 0.04579f
C43 a_179_n82# p0 0.13272f
C44 a_n310_n116# gnd 0.20007f
C45 w_n863_44# a_n850_25# 0.00918f
C46 w_n1123_n69# vdd 0.11088f
C47 w_136_n89# p0 0.06199f
C48 a_n1635_n119# p4 0
C49 a_n1110_n98# p3 0.05934f
C50 a_130_25# a0 0.0683f
C51 a_n1473_n105# a_n1441_n76# 0.61552f
C52 vdd a_n1325_25# 0.20619f
C53 a_n1877_25# gnd 0.53199f
C54 a_n744_22# g2 0.06543f
C55 w_n1196_51# p3 0.0253f
C56 a_n493_n105# gnd 0.20007f
C57 a_147_n111# vdd 0.04199f
C58 a_n350_n76# a_n310_n116# 0.61552f
C59 w_n945_51# s2 0.0253f
C60 w_n1484_n83# C4 0.00933f
C61 w_n1709_n90# vdd 0.17236f
C62 b3 a_n1107_22# 0.05934f
C63 a_210_n118# c0 0
C64 p2 g2 0.45157f
C65 b2 a_n850_25# 0.1137f
C66 vdd g4 0.25107f
C67 a_236_22# gnd 0.31688f
C68 a_n310_n116# vdd 0.04199f
C69 c1 s1 0.41371f
C70 w_117_44# vdd 0.01082f
C71 p3 b3 0.48573f
C72 w_n363_n83# p1 0.02141f
C73 w_223_51# a_236_22# 0.05806f
C74 w_n975_44# C2 0.04346f
C75 a_n1416_n89# a_n1441_n76# 0.13272f
C76 a_n1698_n112# cout 0.05934f
C77 a2 C2 0.00477f
C78 a_n1107_22# a_n1114_22# 0.2065f
C79 p2 s2 0.48573f
C80 vdd a_n1877_25# 0.20619f
C81 p0 gnd 0.00633f
C82 C4 s4 0.41371f
C83 w_n1672_51# a4 0.04579f
C84 a_n1410_n112# c3 0
C85 a_n493_n105# vdd 0.04199f
C86 w_n140_51# vdd 0.11088f
C87 w_117_44# a0 0.04346f
C88 w_147_51# b0 0.05959f
C89 pB w_n1123_n69# 0.00933f
C90 a_n1666_n83# p4 0.13272f
C91 a_236_22# vdd 0.497f
C92 w_n1748_51# p4 0.0253f
C93 a_n833_n111# gnd 0.20007f
C94 gnd s0 0.00143f
C95 w_n328_51# vdd 0.02162f
C96 b4 a4 0.07107f
C97 w_n844_n89# p2 0.06199f
C98 w_35_51# p0 0.05959f
C99 a_n1290_n116# w_n1343_n83# 0.0306f
C100 a_179_n82# a_210_n118# 0.10997f
C101 a3 a_n1213_25# 0.0683f
C102 a0 a_236_22# 0.10116f
C103 a2 gnd 0.04693f
C104 p0 vdd 0.21677f
C105 g0 c1 0.00202f
C106 a_n777_n118# p2 0.10997f
C107 a_n1290_n116# gnd 0.20007f
C108 a_n1330_n112# a_n1314_n112# 0.20619f
C109 gnd g1 1.00707f
C110 w_n833_51# vdd 0.02162f
C111 w_n140_51# a_n127_22# 0.05806f
C112 a_n430_n112# c1 0
C113 a_n1441_n76# w_n1484_n83# 0.04274f
C114 w_35_51# s0 0.0253f
C115 p2 c3 0.00188f
C116 p0 a0 0.4546f
C117 a_n1107_22# gnd 0.31688f
C118 b1 vdd 0.07516f
C119 a_n1441_n76# c3 0.05862f
C120 a_n1473_n105# gnd 0.20007f
C121 a_n833_n111# vdd 0.04199f
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
C577 C4 0 2.29003f ;FLOATING
C578 a_236_22# 0 0.80626f ;FLOATING
C579 a0 0 2.00793f ;FLOATING
C580 b0 0 1.60617f ;FLOATING
C581 p0 0 3.66362f ;FLOATING
C582 a_n127_22# 0 0.80626f ;FLOATING
C583 a1 0 2.00793f ;FLOATING
C584 b1 0 1.60617f ;FLOATING
C585 p1 0 3.02943f ;FLOATING
C586 a_n744_22# 0 0.80626f ;FLOATING
C587 a2 0 2.00793f ;FLOATING
C588 b2 0 1.60617f ;FLOATING
C589 p2 0 3.66362f ;FLOATING
C590 a_n1107_22# 0 0.80626f ;FLOATING
C591 a3 0 2.00793f ;FLOATING
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
