munchsubal/5-bit-cla/FPGA/design sources/cla_block.v

module cla_block(
    input  [4:0] p,
    input  [4:0] g,
    output [5:0] c
);

    assign c[1] = g[0] | (p[0] & c[0]);
    assign c[2] = g[1] | (p[1] & c[1]);
    assign c[3] = g[2] | (p[2] & c[2]);
    assign c[4] = g[3] | (p[3] & c[3]);
    assign c[5] = g[4] | (p[4] & c[4]);

endmodule
